Ne-Se-Chete/CableUndefined-Embedded/assets/cable-undefined-poster.pdf

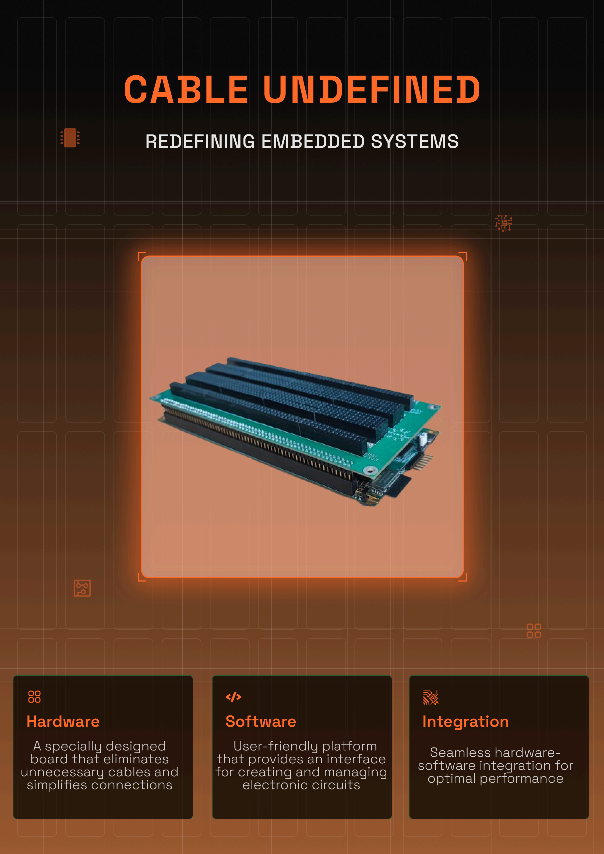
[picture p6: page 1]
