Ne-Se-Chete/CableUndefined-Embedded/assets/gemji-2025.02.01.jpg

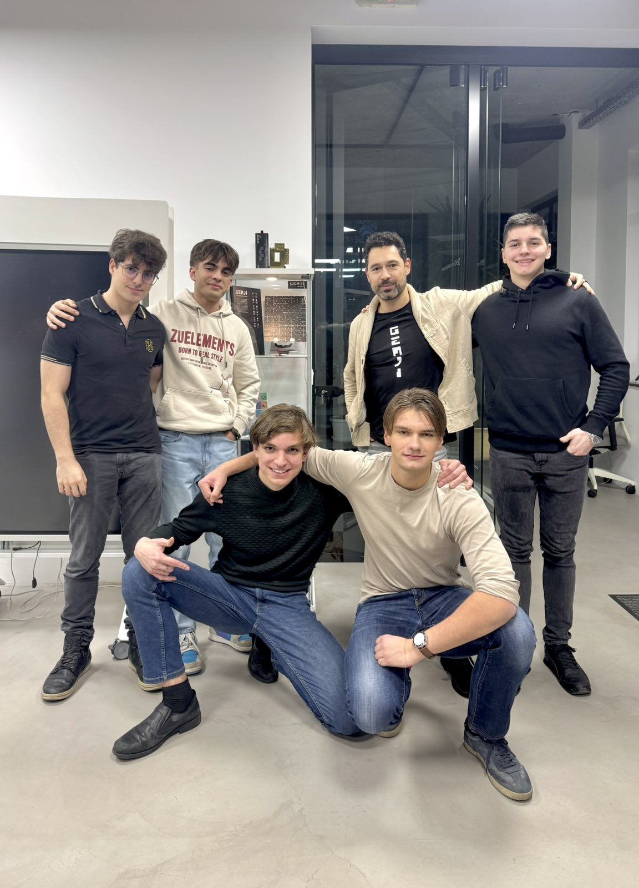
assets/gemji-2025.02.01.jpg
