Ne-Se-Chete/CableUndefined-Embedded/assets/IMG_20231005_111330.jpg

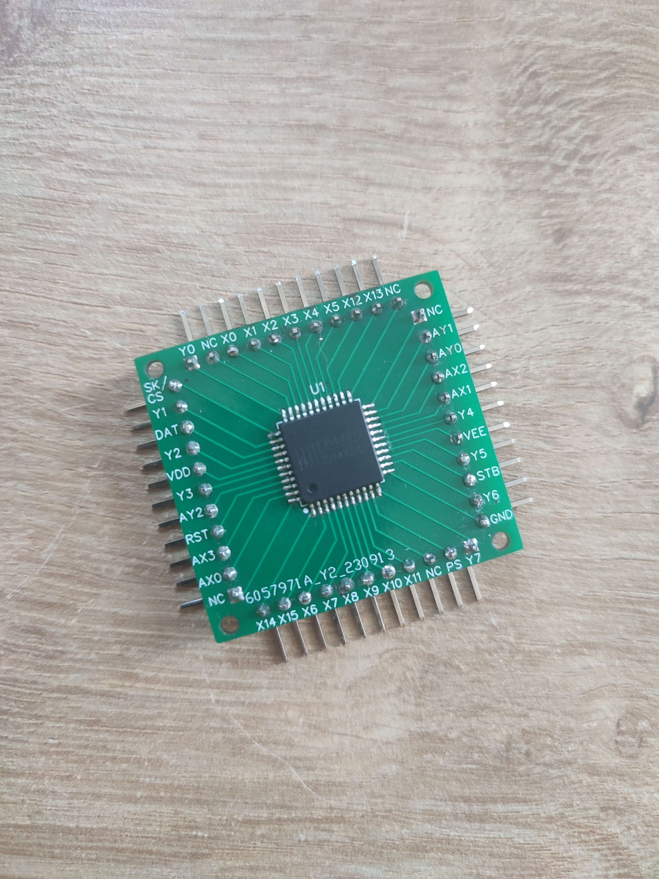
assets/IMG_20231005_111330.jpg
