Ne-Se-Chete/CableUndefined-Embedded/assets/IMG_20240214_160135.jpg

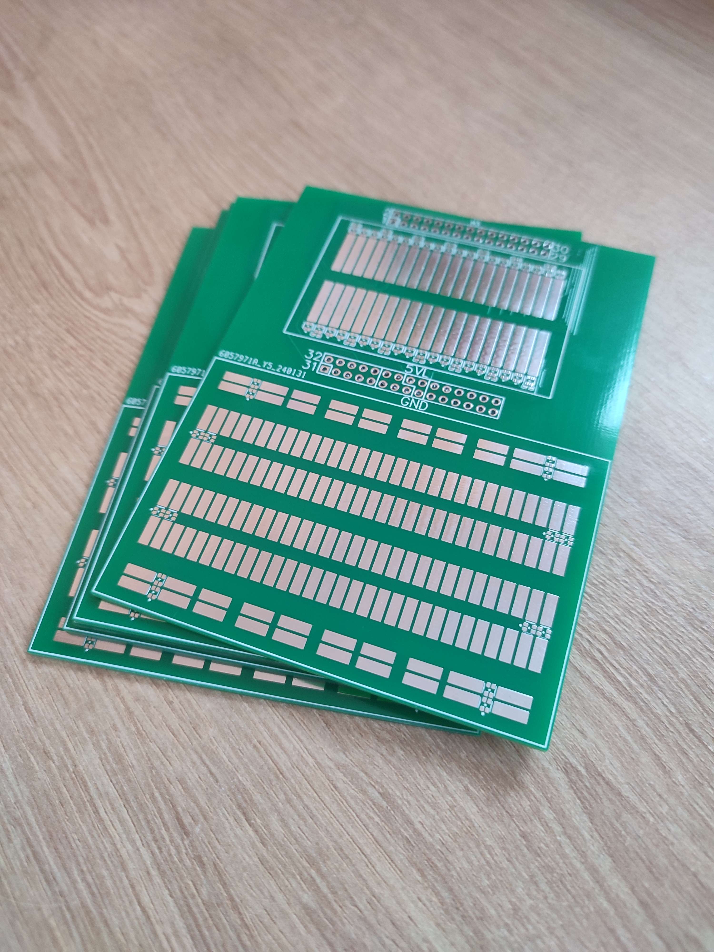
assets/IMG_20240214_160135.jpg
