Ne-Se-Chete/CableUndefined-Embedded/assets/IMG_20240214_160146.jpg

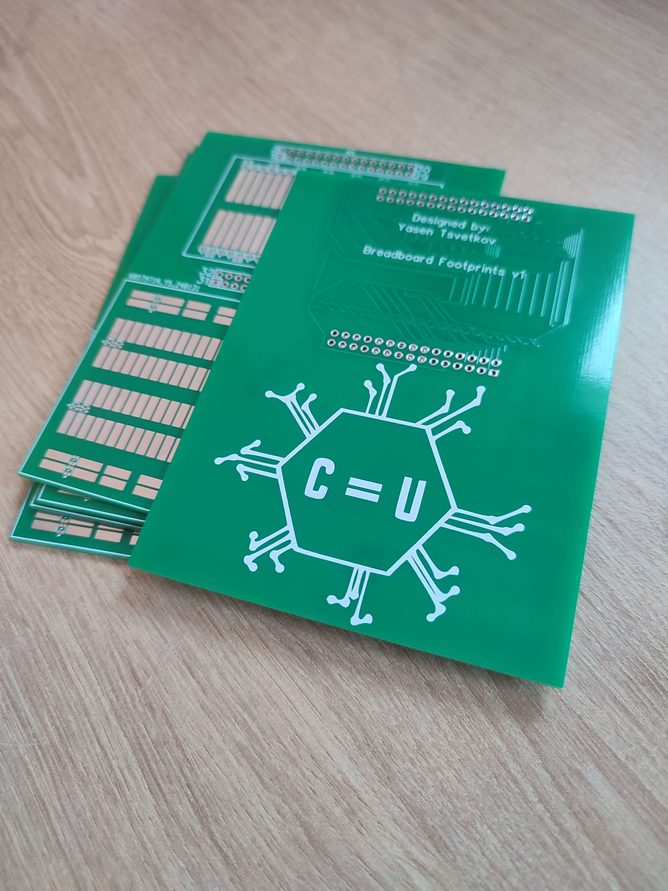
assets/IMG_20240214_160146.jpg
