Ne-Se-Chete/CableUndefined-Embedded/assets/IMG_20240329_173710.jpg

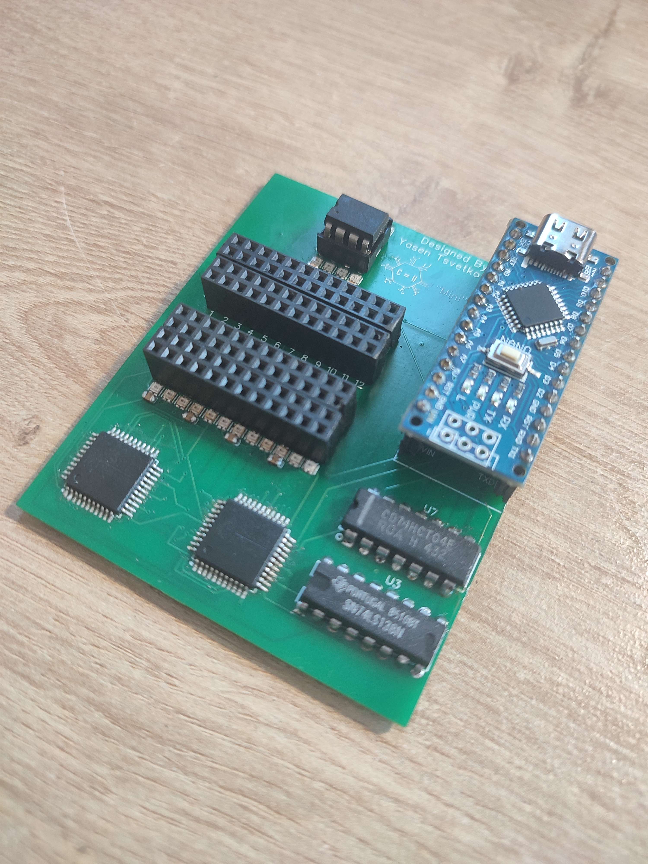
assets/IMG_20240329_173710.jpg
