Ne-Se-Chete/CableUndefined-Embedded/assets/IMG_20240329_173838.jpg

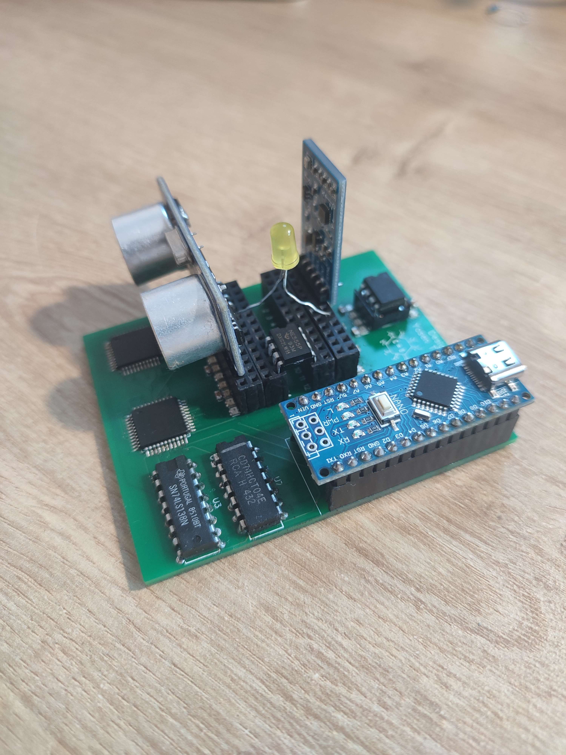
assets/IMG_20240329_173838.jpg
