Ne-Se-Chete/CableUndefined-Embedded/assets/IMG_20240329_174744.jpg

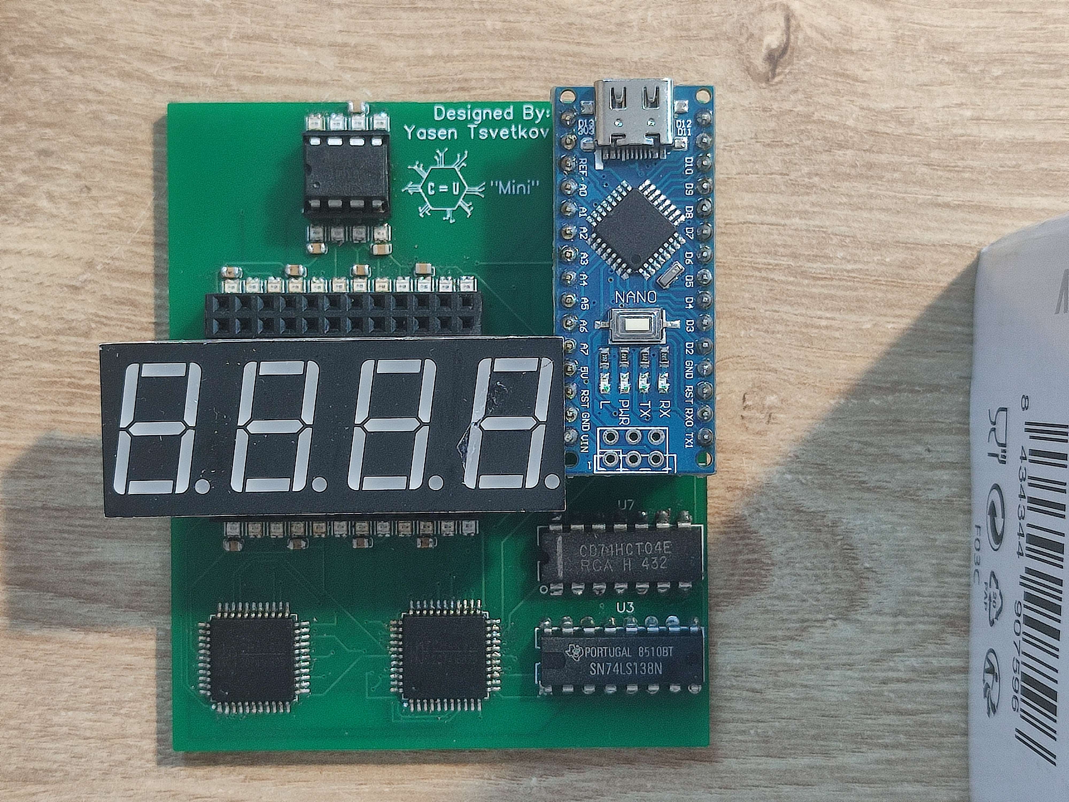
assets/IMG_20240329_174744.jpg
