Ne-Se-Chete/CableUndefined-Embedded/assets/IMG_20240329_174848.jpg

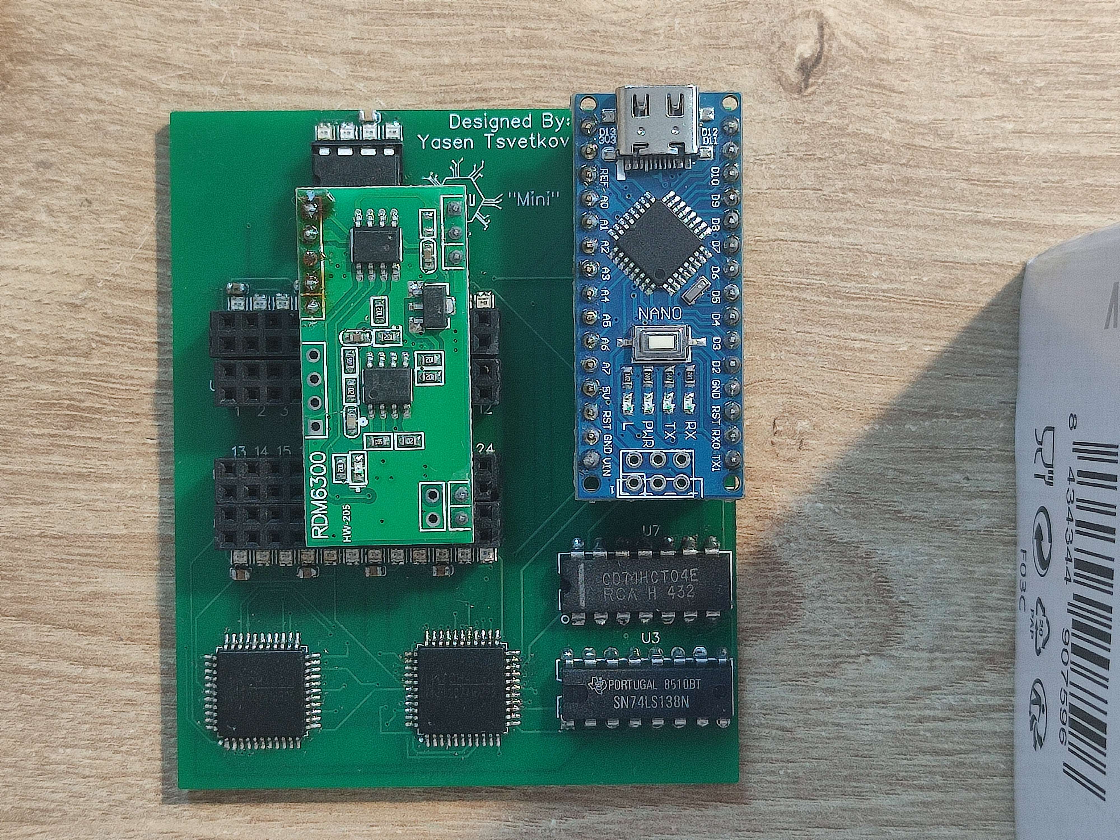
assets/IMG_20240329_174848.jpg
