Ne-Se-Chete/CableUndefined-Embedded/assets/IMG_20240329_175025.jpg

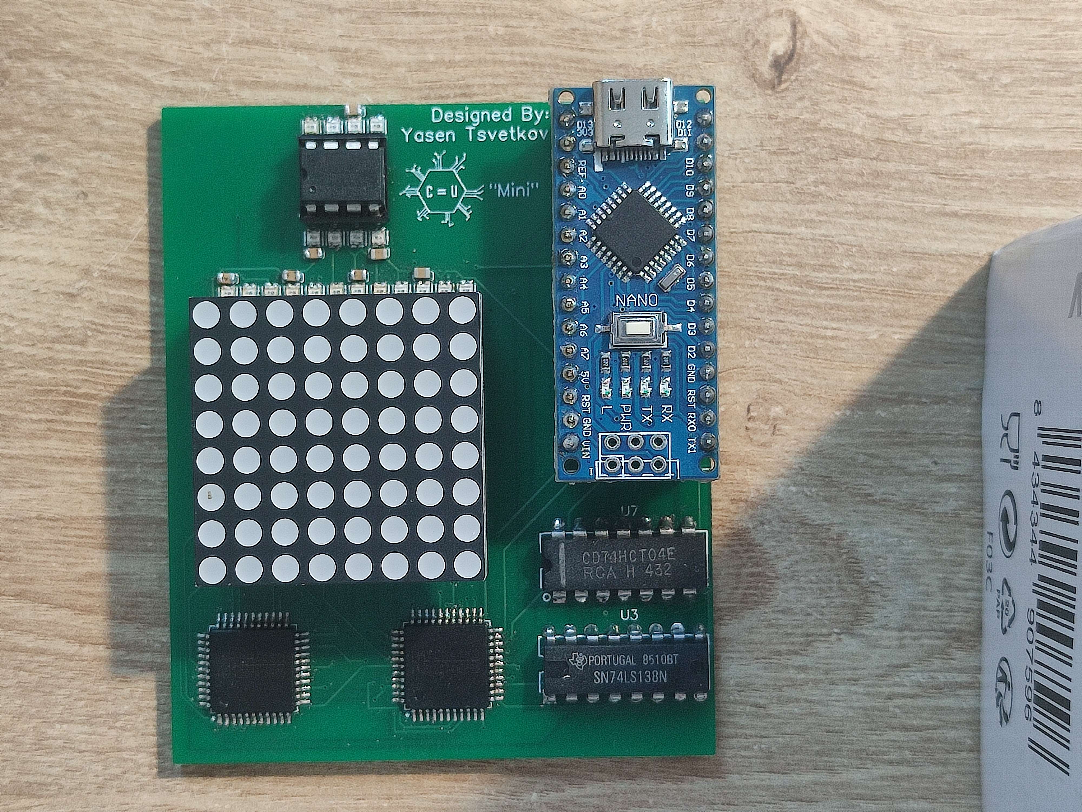
assets/IMG_20240329_175025.jpg
