Ne-Se-Chete/CableUndefined-Embedded/assets/IMG_20240329_175111.jpg

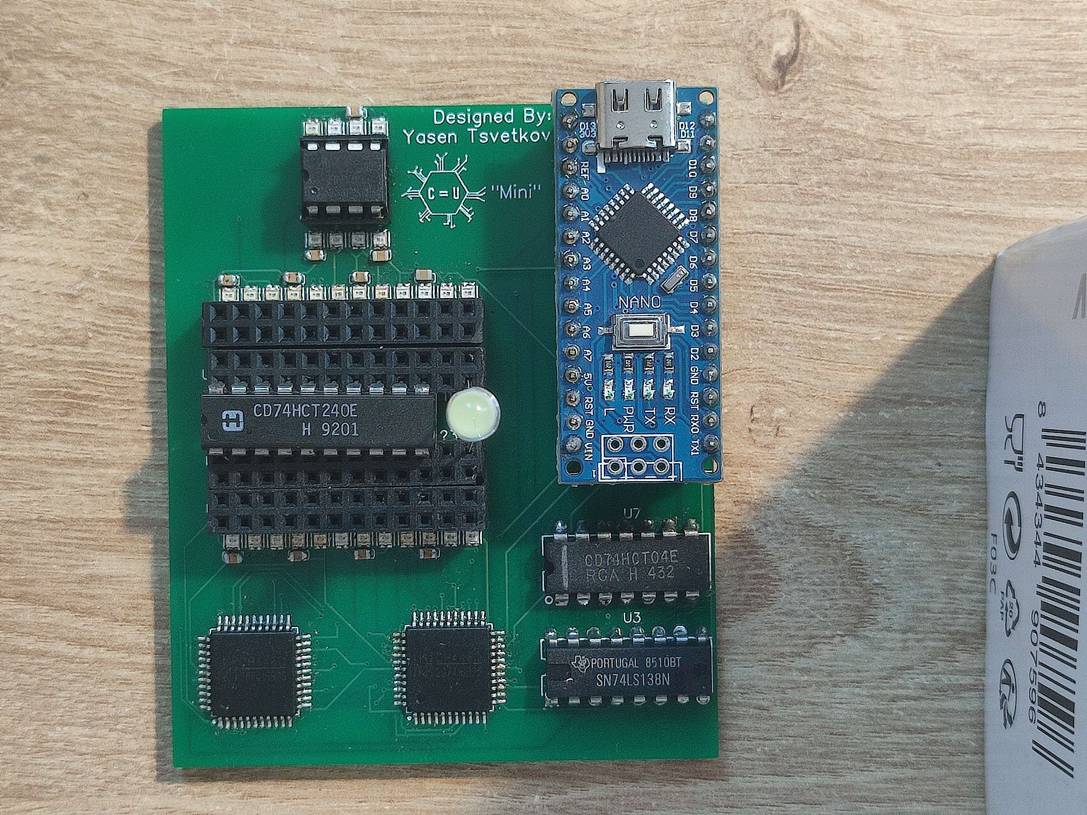
assets/IMG_20240329_175111.jpg
