Ne-Se-Chete/CableUndefined-Embedded/assets/IMG_20240329_175406.jpg

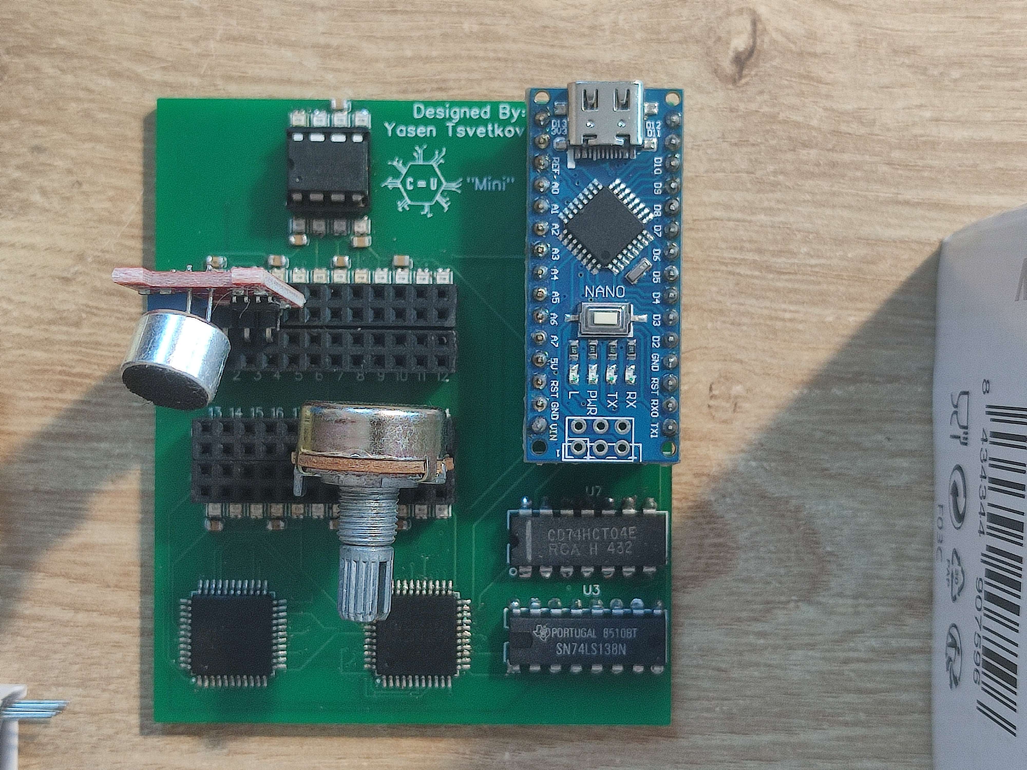
assets/IMG_20240329_175406.jpg
