Ne-Se-Chete/CableUndefined-Embedded/assets/nsc-2.jpg

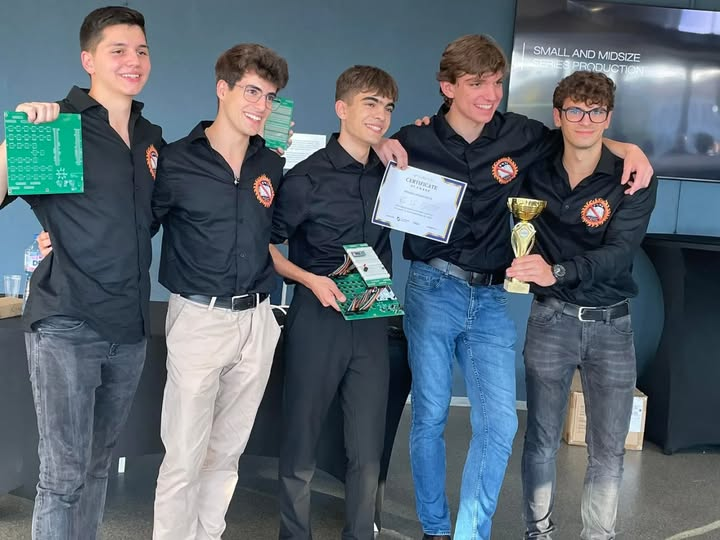
assets/nsc-2.jpg
