Ne-Se-Chete/CableUndefined-Embedded/assets/viber_image_2025-03-26_13-28-42-523.jpg

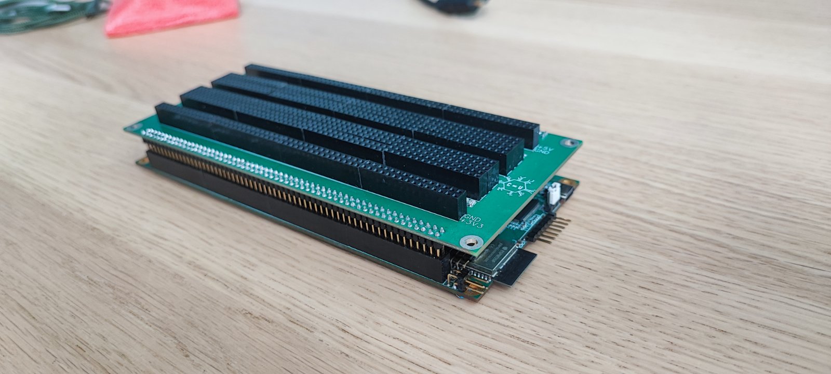
assets/viber_image_2025-03-26_13-28-42-523.jpg
