Ne-Se-Chete/CableUndefined-Embedded/assets/viber_image_2025-03-26_13-28-44-215.jpg

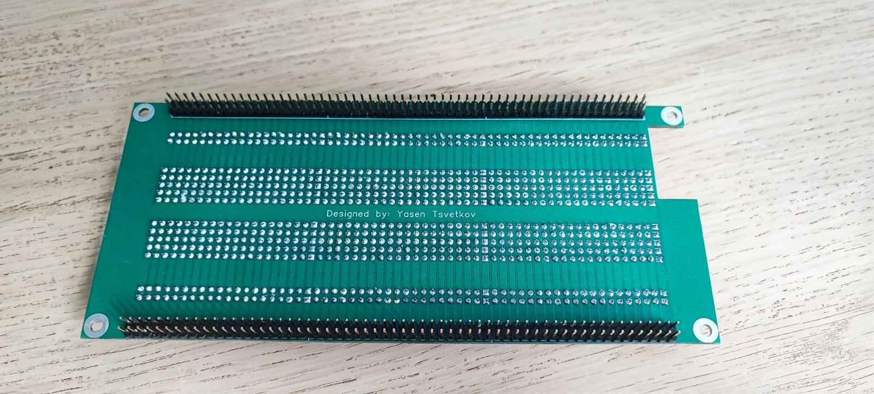
assets/viber_image_2025-03-26_13-28-44-215.jpg
