Ne-Se-Chete/CableUndefined-Embedded/assets/viber_image_2025-03-26_13-28-46-500.jpg

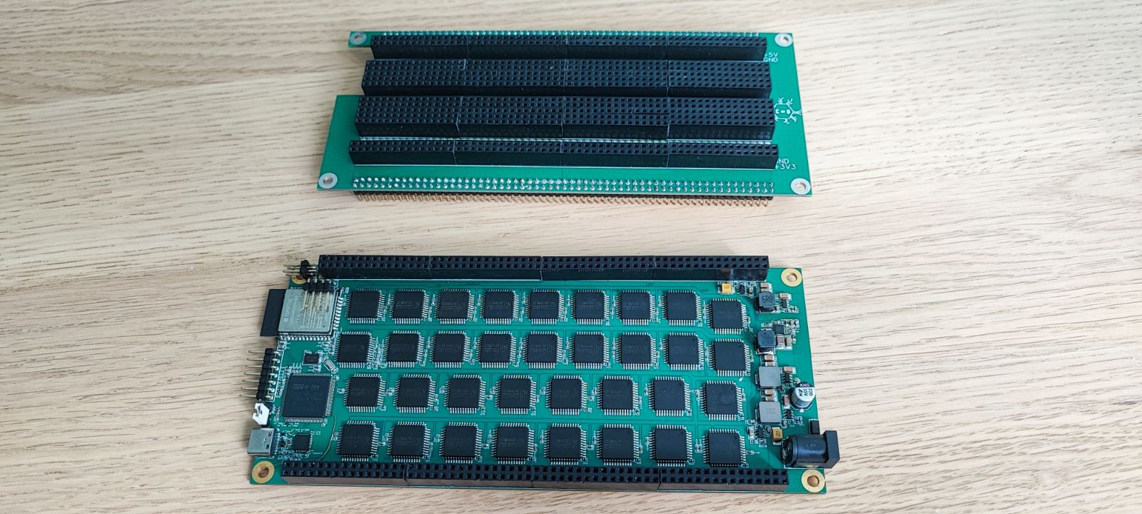
assets/viber_image_2025-03-26_13-28-46-500.jpg
