Ne-Se-Chete/CableUndefined-Embedded/assets/viber_image_2025-03-26_13-30-22-813.jpg

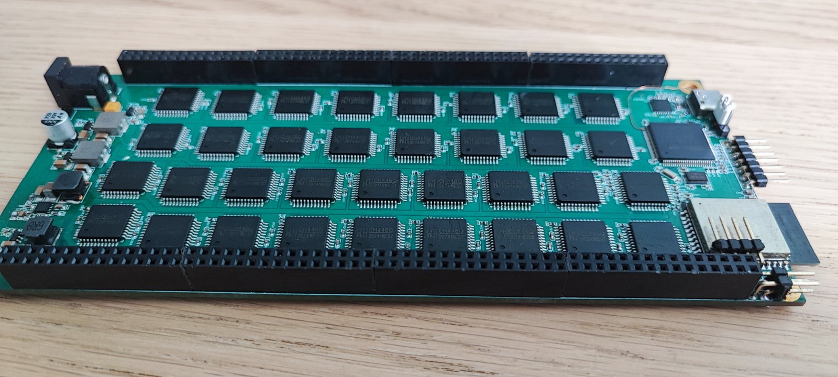
assets/viber_image_2025-03-26_13-30-22-813.jpg
