Ne-Se-Chete/CableUndefined-Embedded/assets/viber_image_2025-03-26_13-31-24-213.jpg

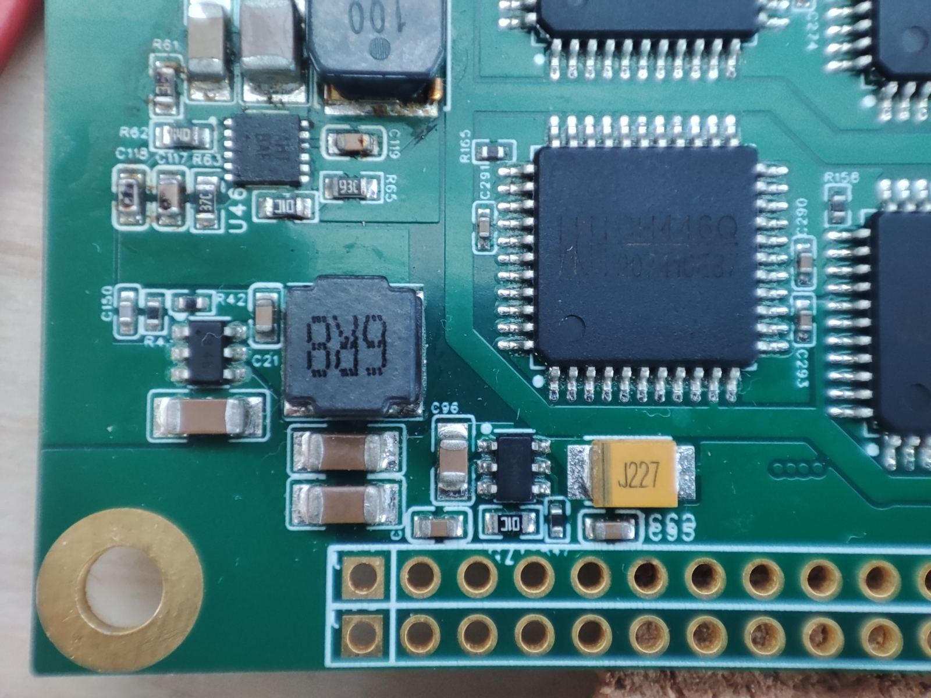
assets/viber_image_2025-03-26_13-31-24-213.jpg
