Ne-Se-Chete/CableUndefined-Embedded/assets/viber_image_2025-03-26_13-31-25-889.jpg

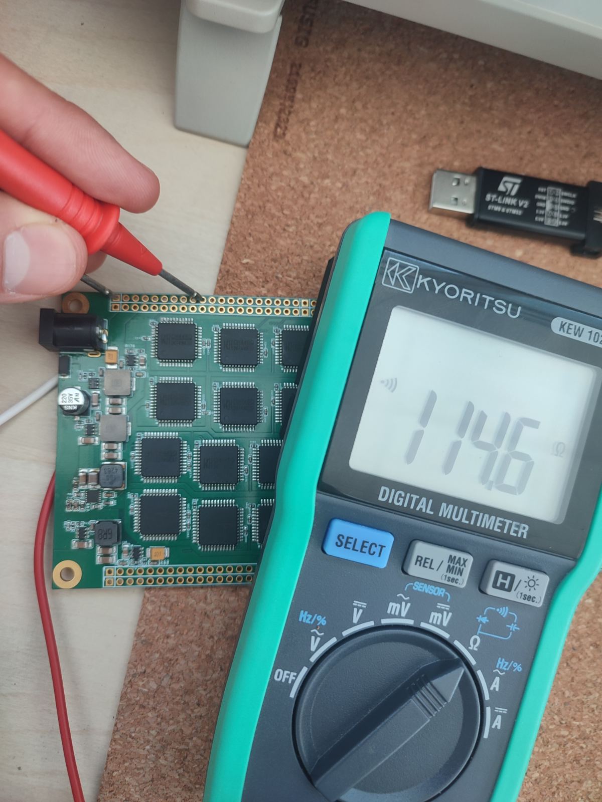
assets/viber_image_2025-03-26_13-31-25-889.jpg
