Ne-Se-Chete/CableUndefined-Embedded/(threads)

Thread 11 (2025-03-10):

Research web sockets in Spring Boot

TIVMOF, 2025-03-10:
Research how web sockets work with Spring Boot and plan next issues accordingly.

Closed 2025-04-15.
