Ne-Se-Chete/CableUndefined-Embedded/Cable Undefined V3/Schematics/Cable Undefined Bottom.pdf

# NC 15 NC 16 NC 17 NC 18 NC 19 NC 20 NC 21

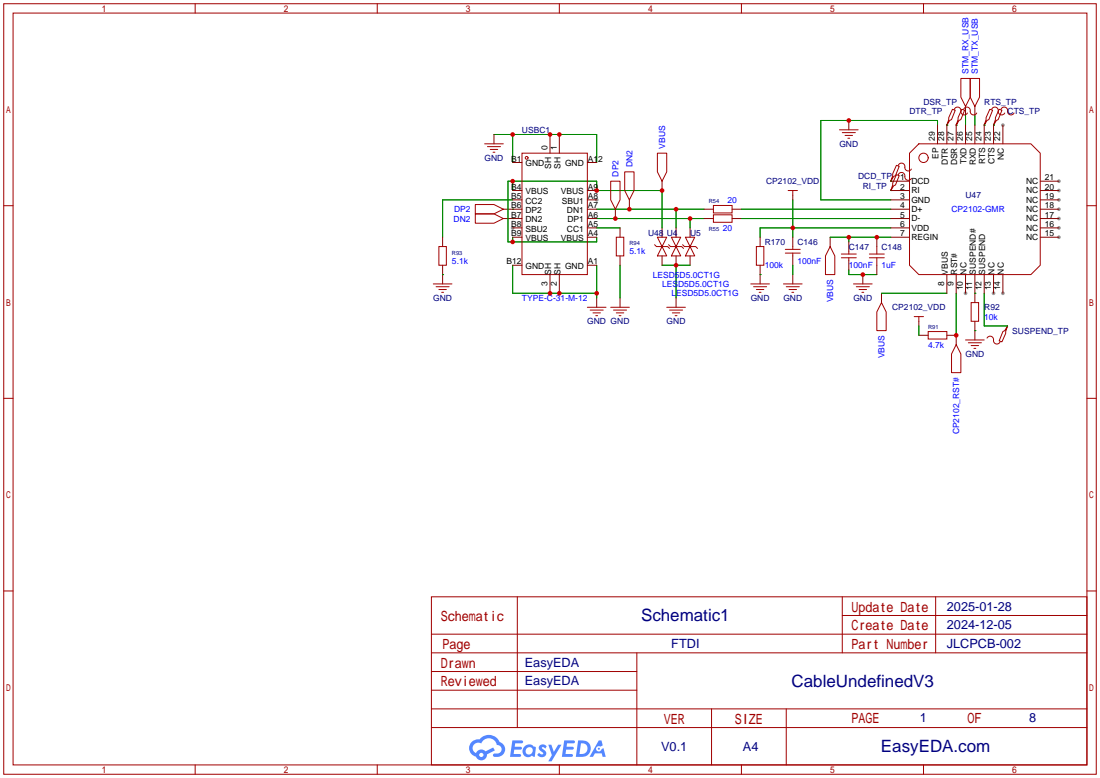
[picture p39: page 1]

NC 22 CTS 23 RTS 24 RXD 25 TXD 26 DSR 27 DTR 28 EP 29

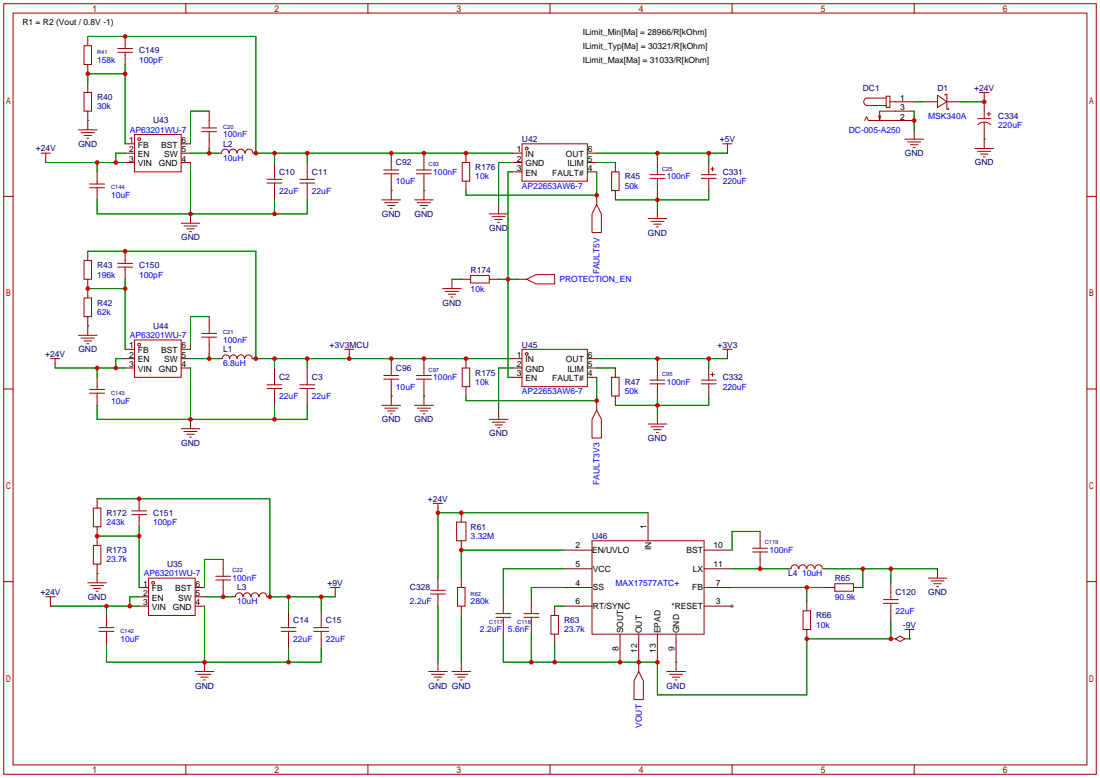
[picture p40: page 2]

# Breadboard TOP MUXes

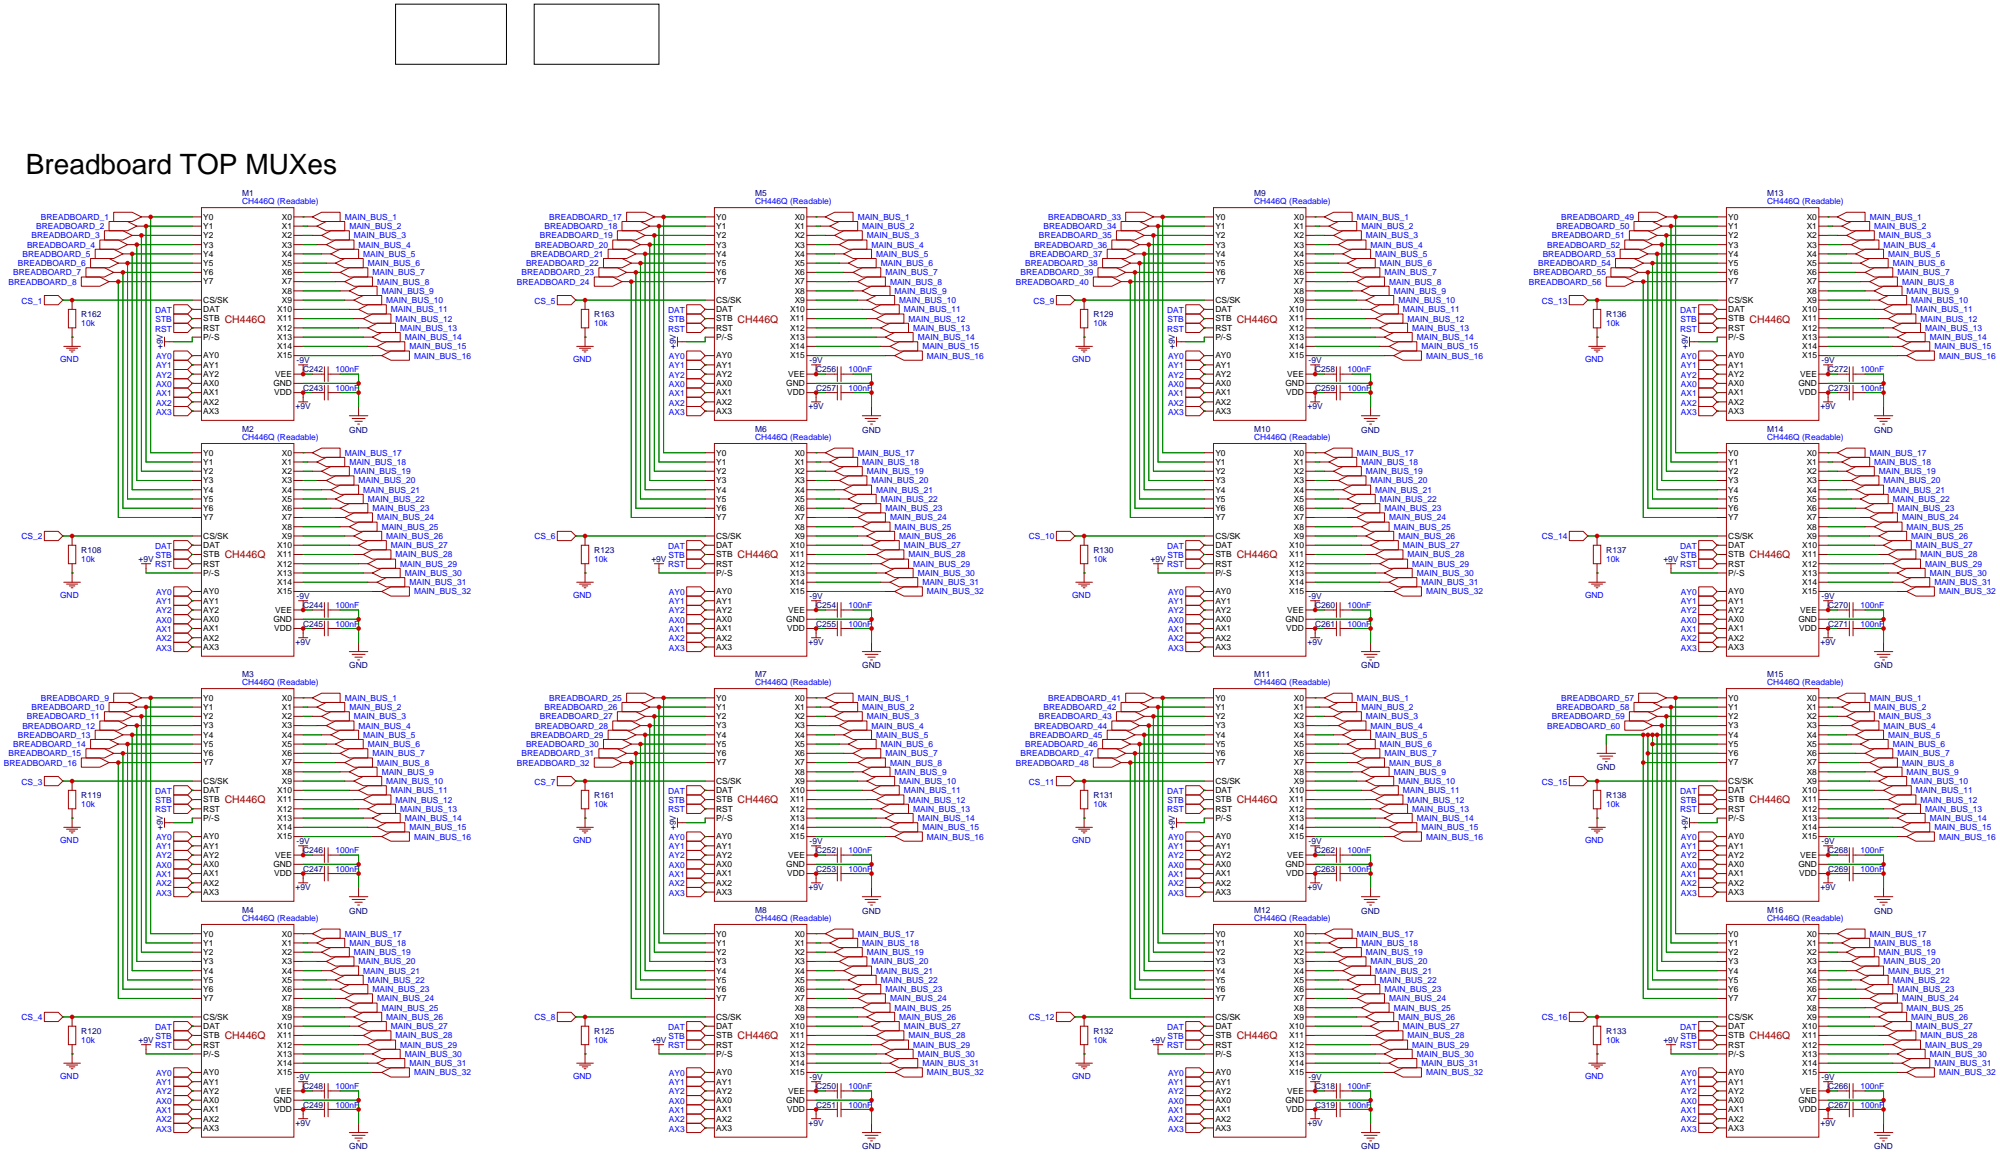
[picture p41: page 3]

### CH446Q

### CH446Q

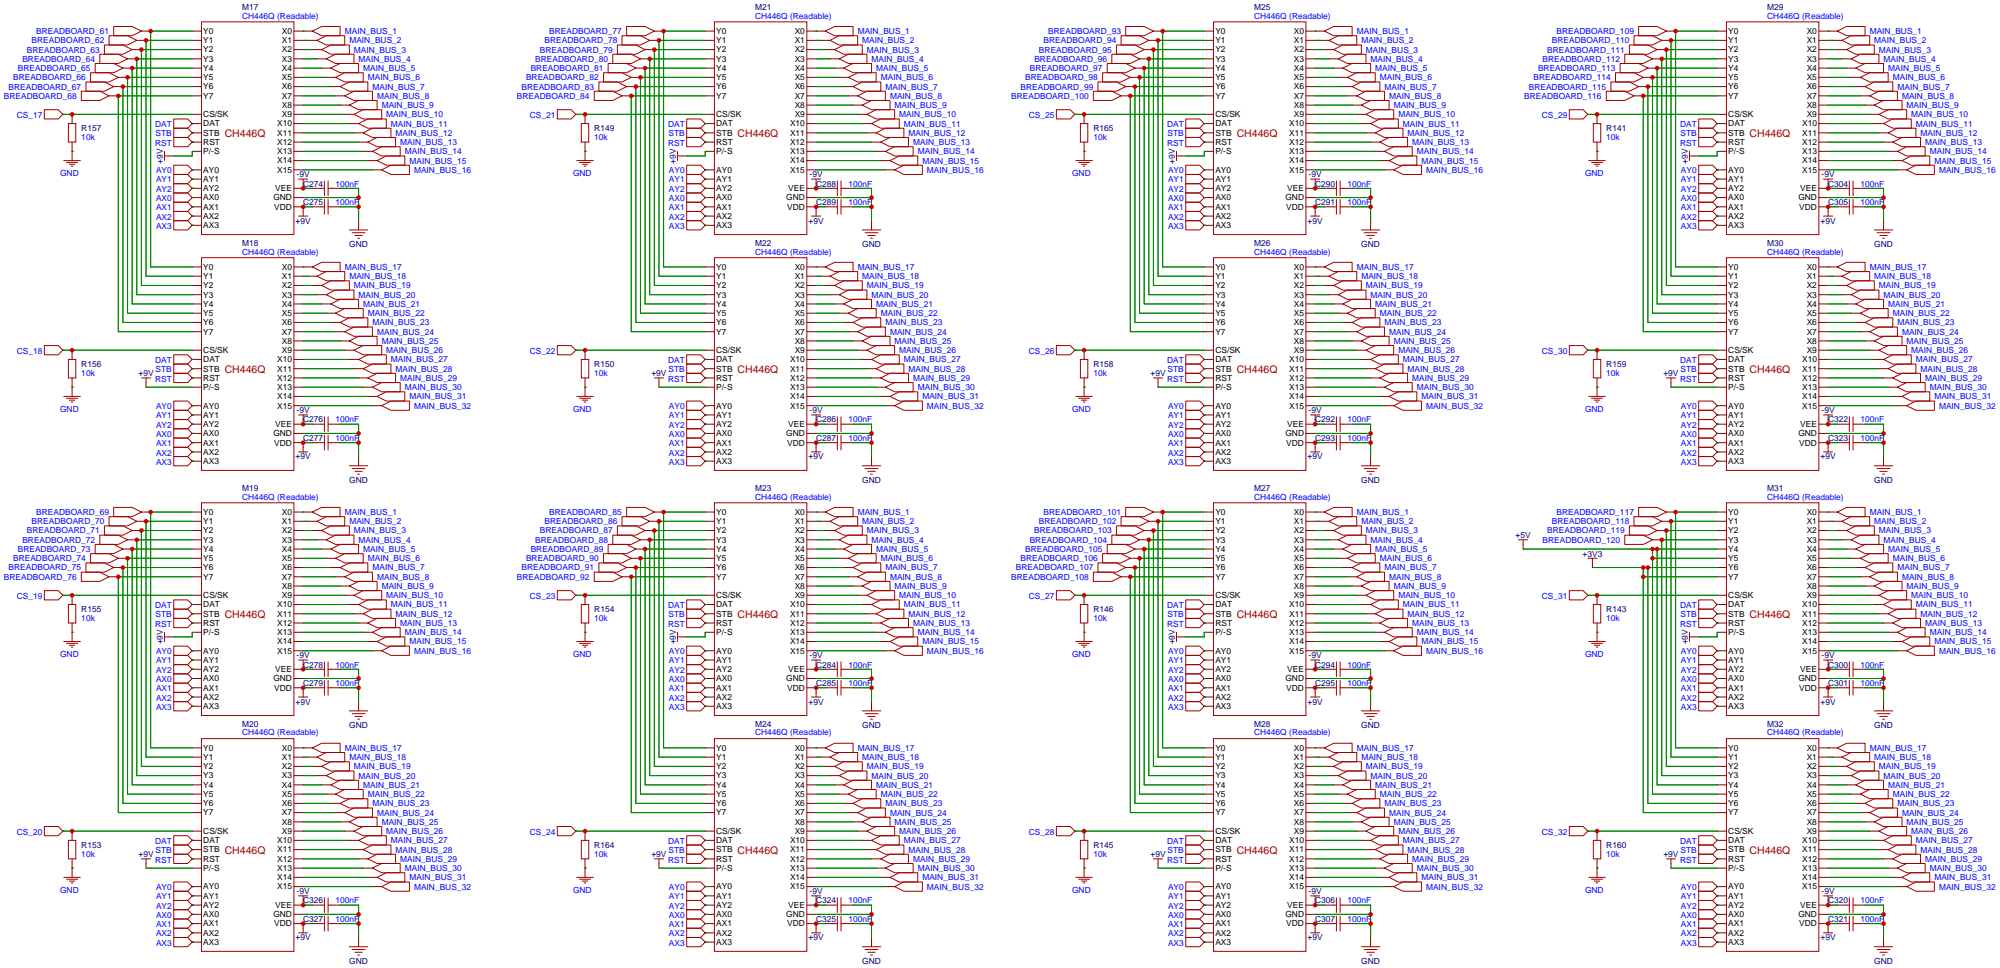
[picture p42: page 4]

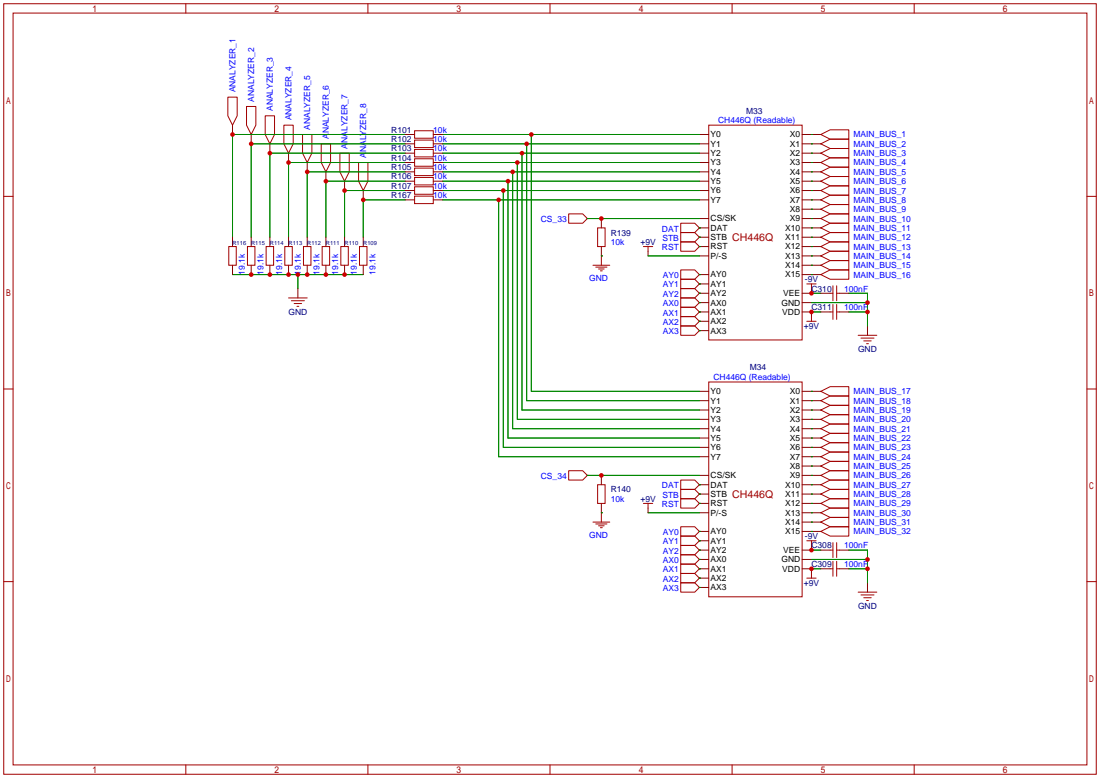
[picture p43: page 5]

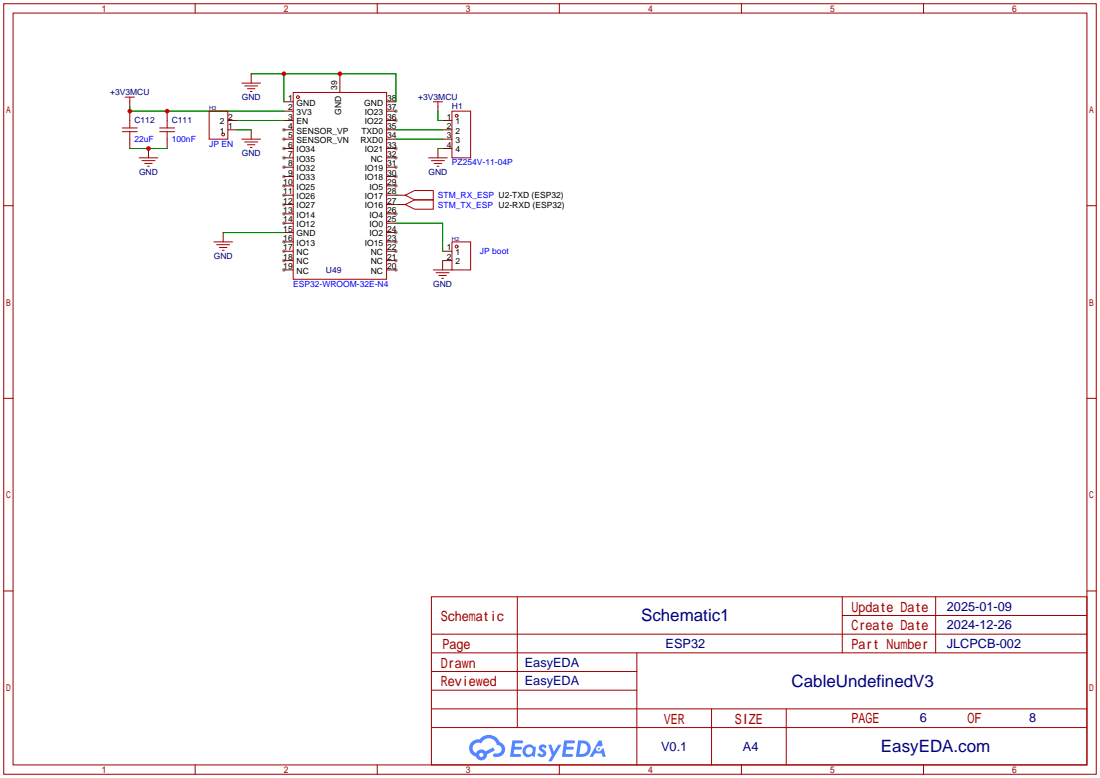
[picture p44: page 6]

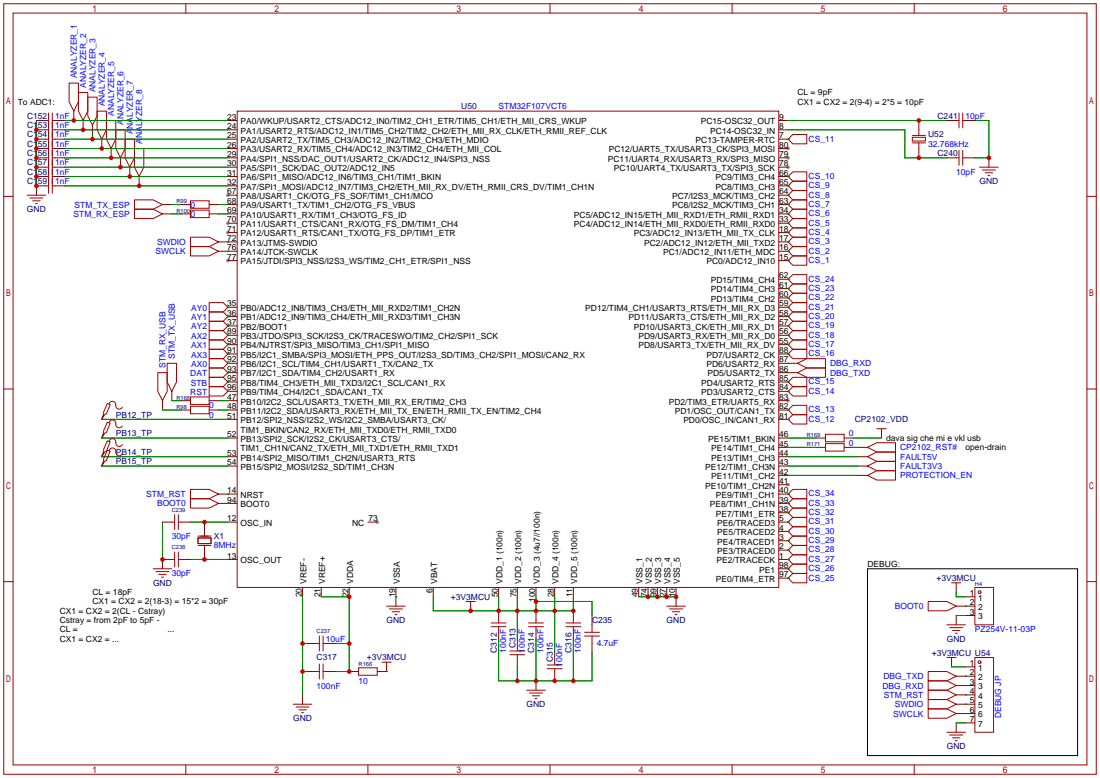
[picture p45: page 7]

CX1 = CX2 = 2(CL - Cstray)
Cstray = from 2pF to 5pF - Паразитен капацитет на пистата
CL = на кристала...

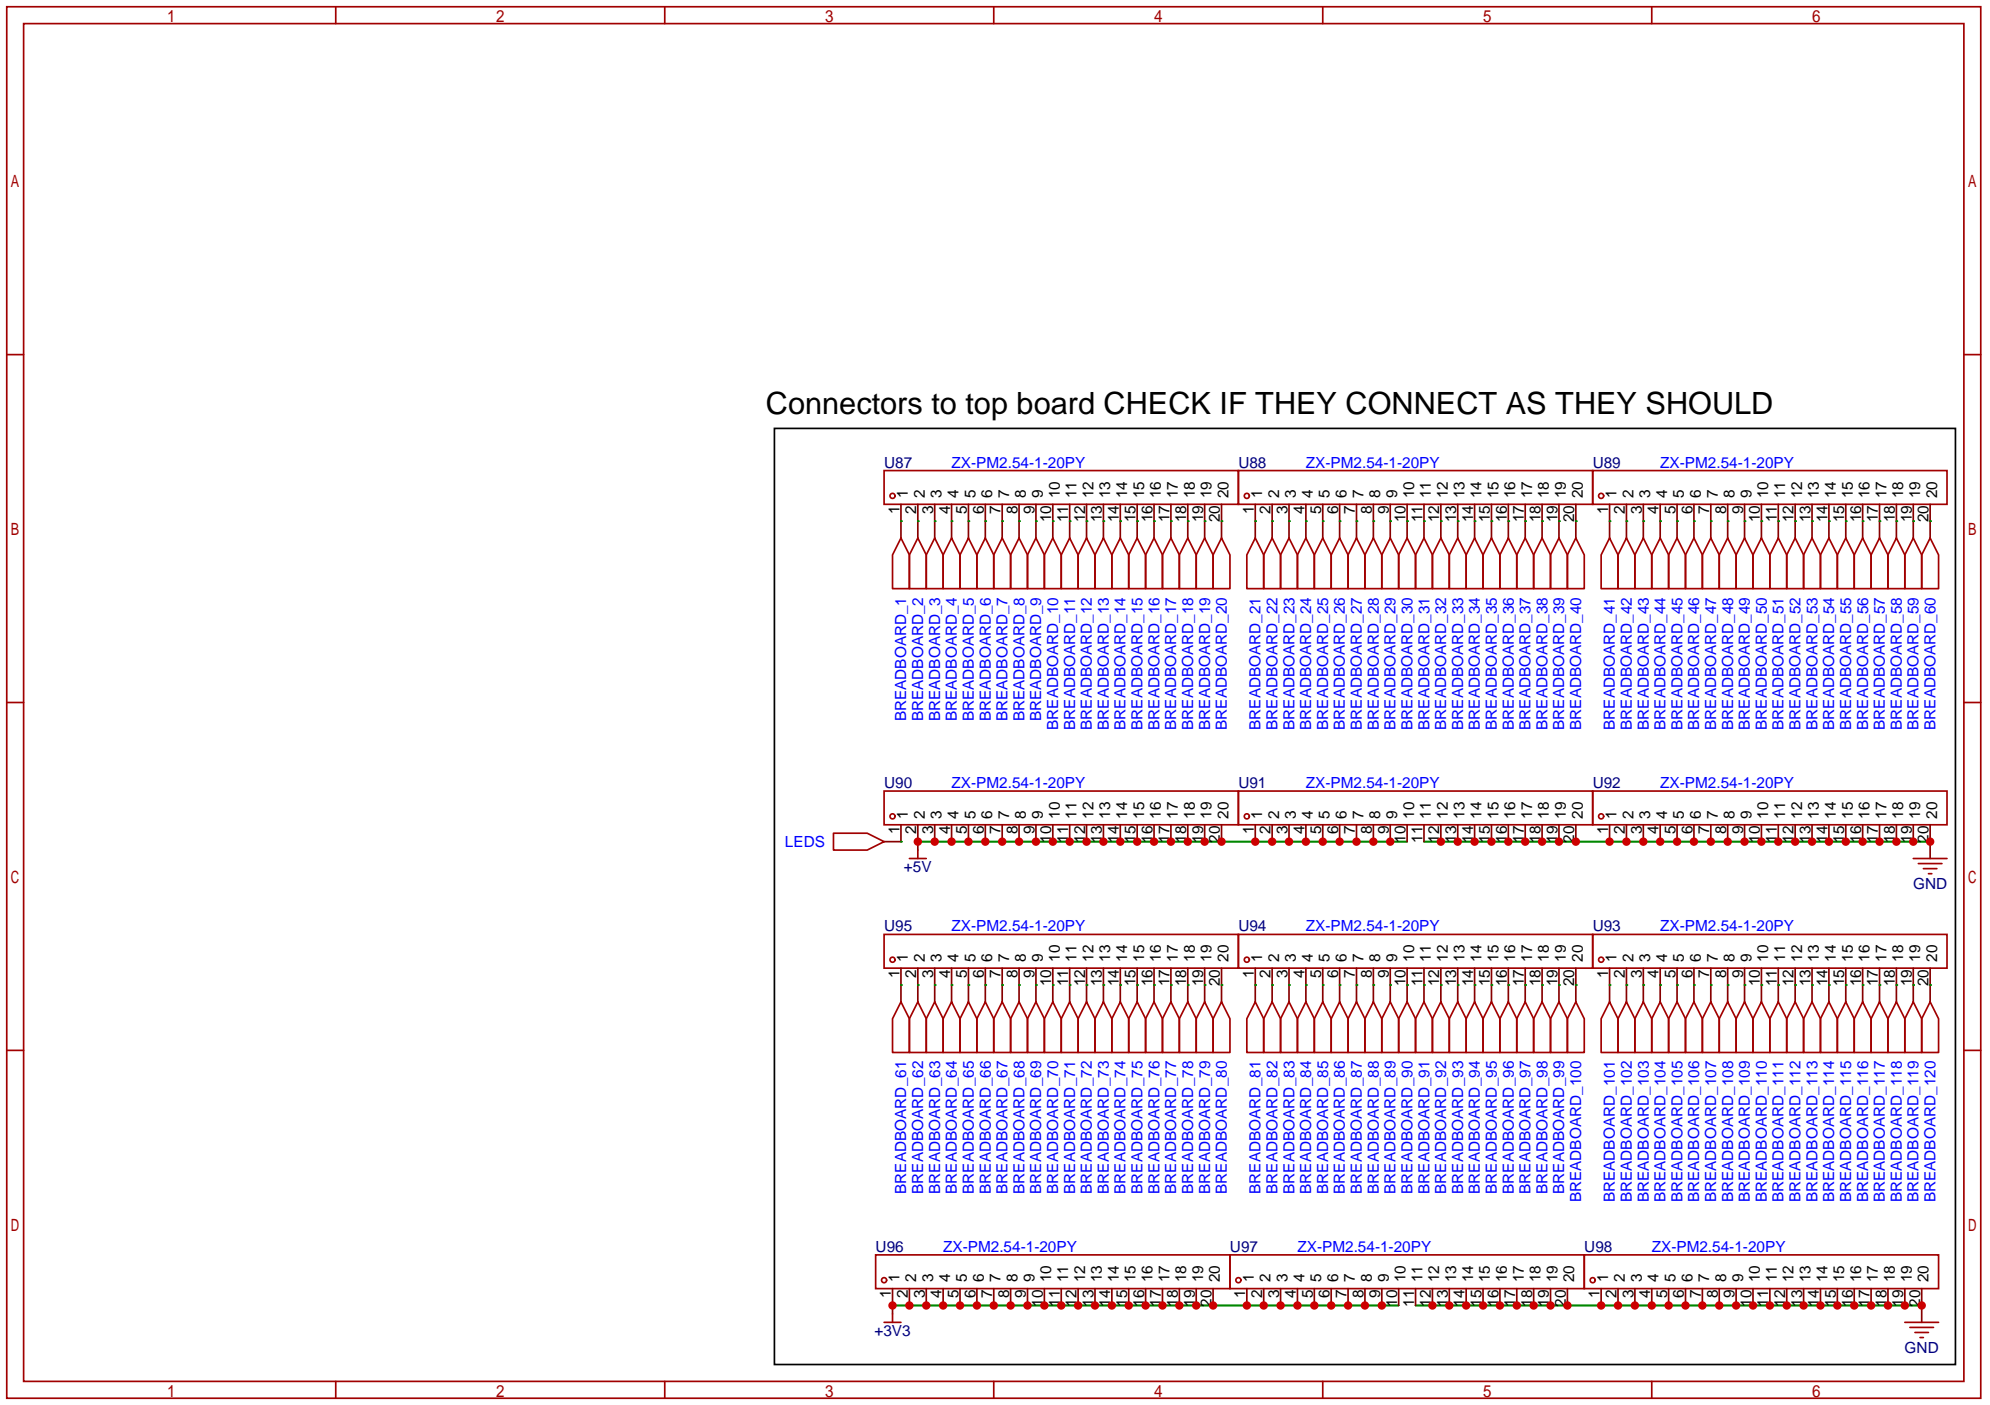
[picture p46: page 8]

Connectors to top board CHECK IF THEY CONNECT AS THEY SHOULD
