Ne-Se-Chete/CableUndefined-Embedded/Cable Undefined V3/Schematics/Cable Undefined Top.pdf

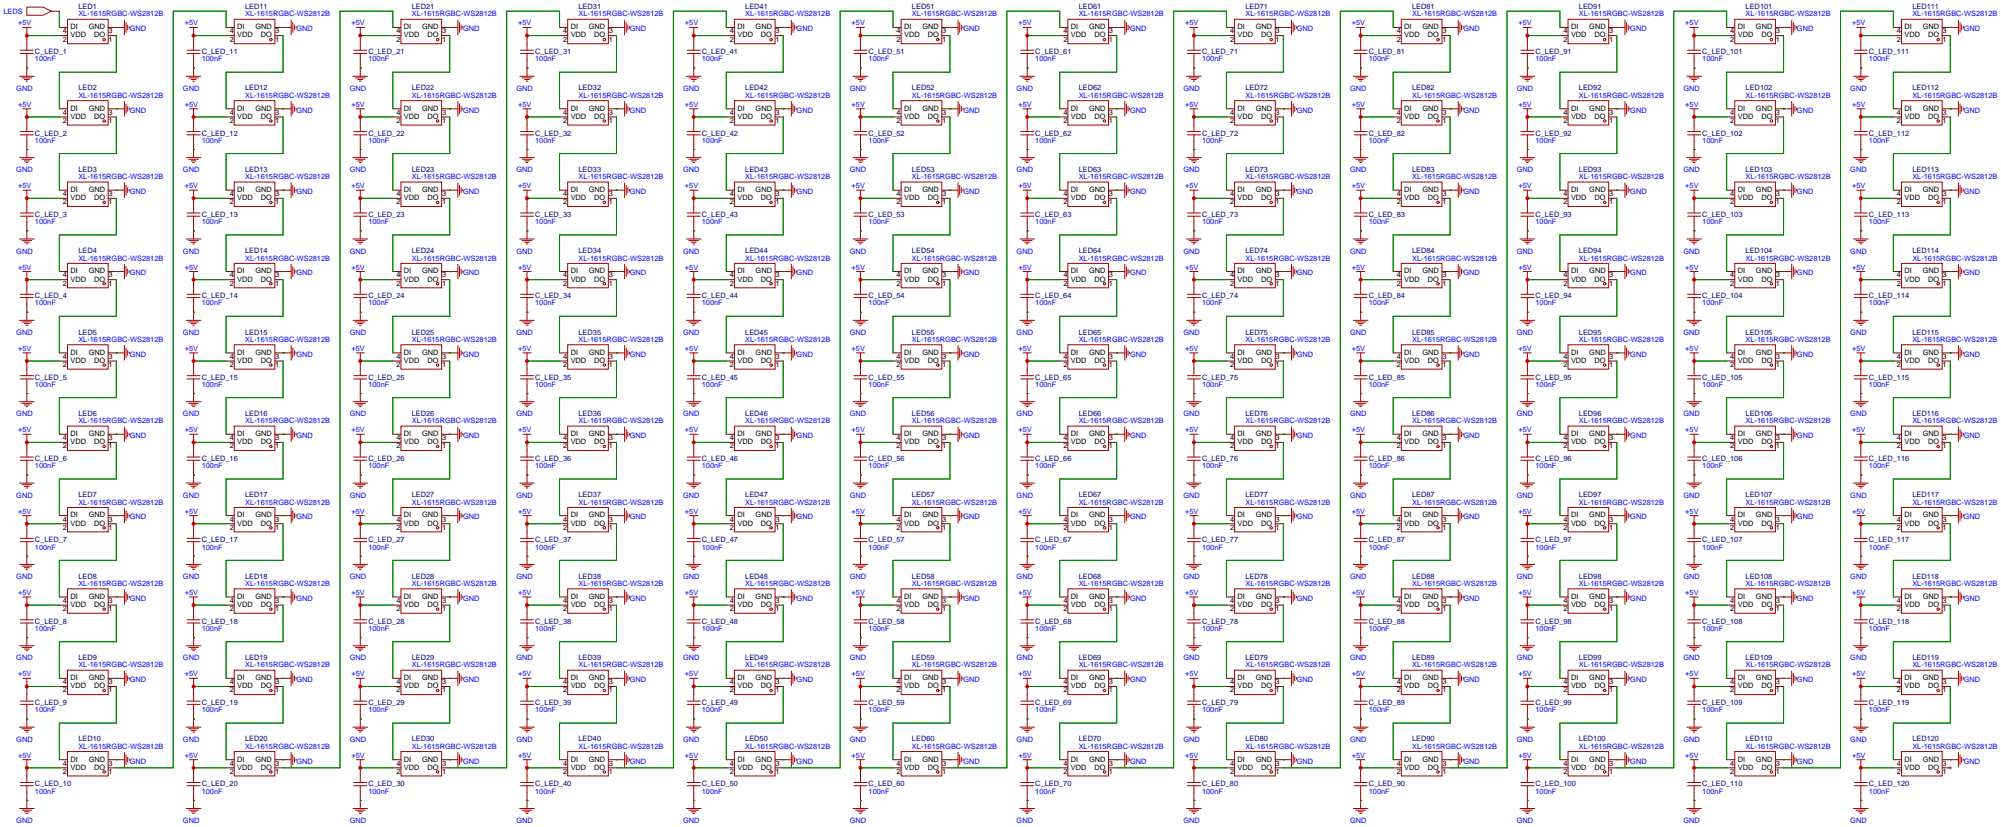
[picture p47: page 1]

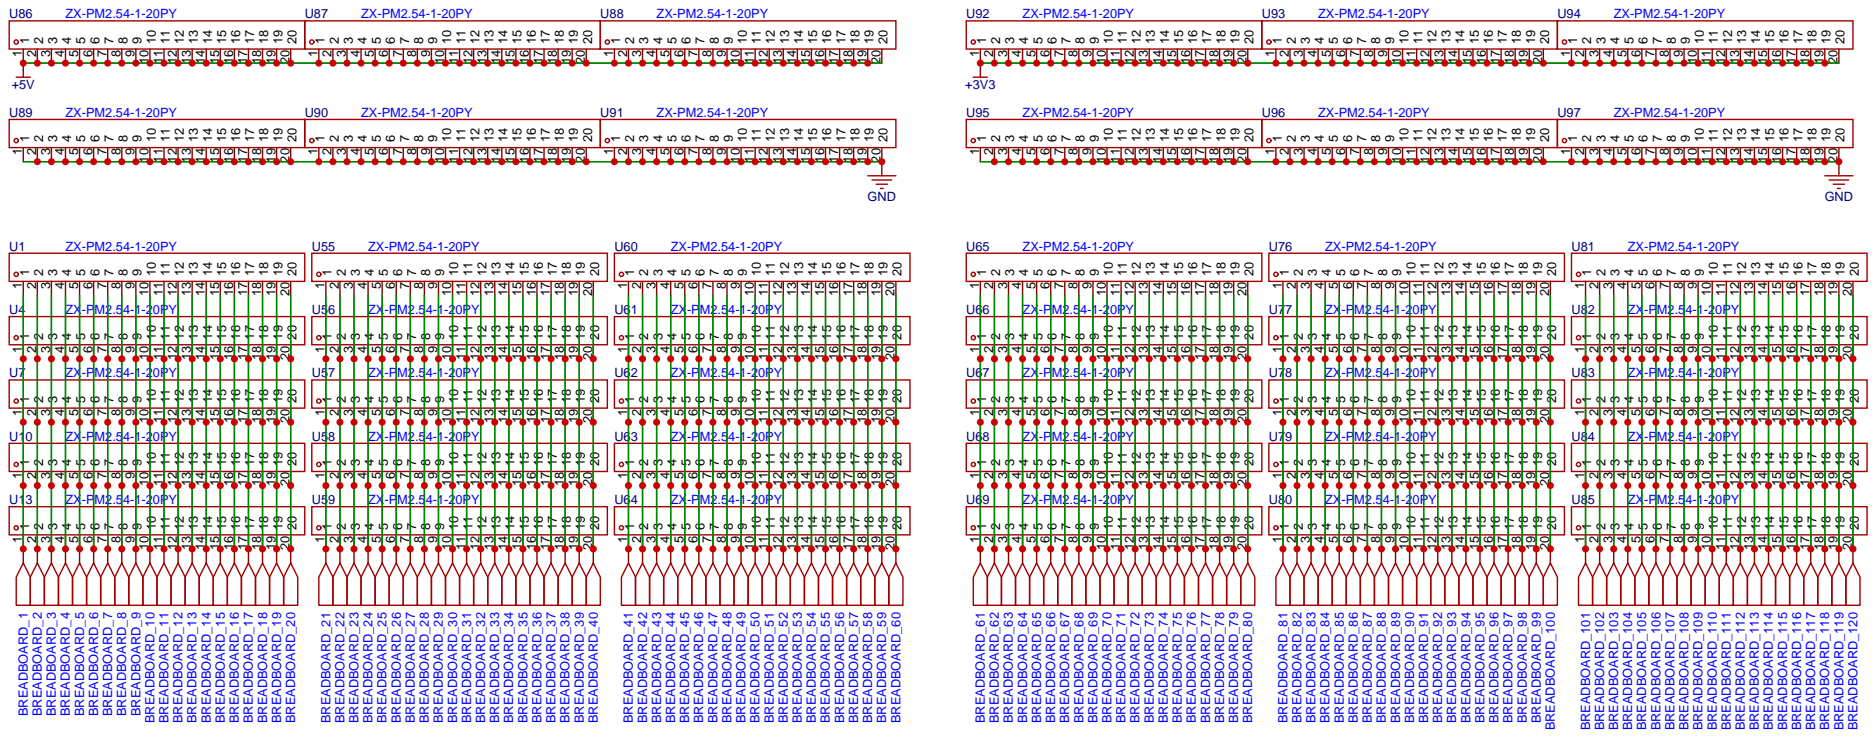
[picture p48: page 2]

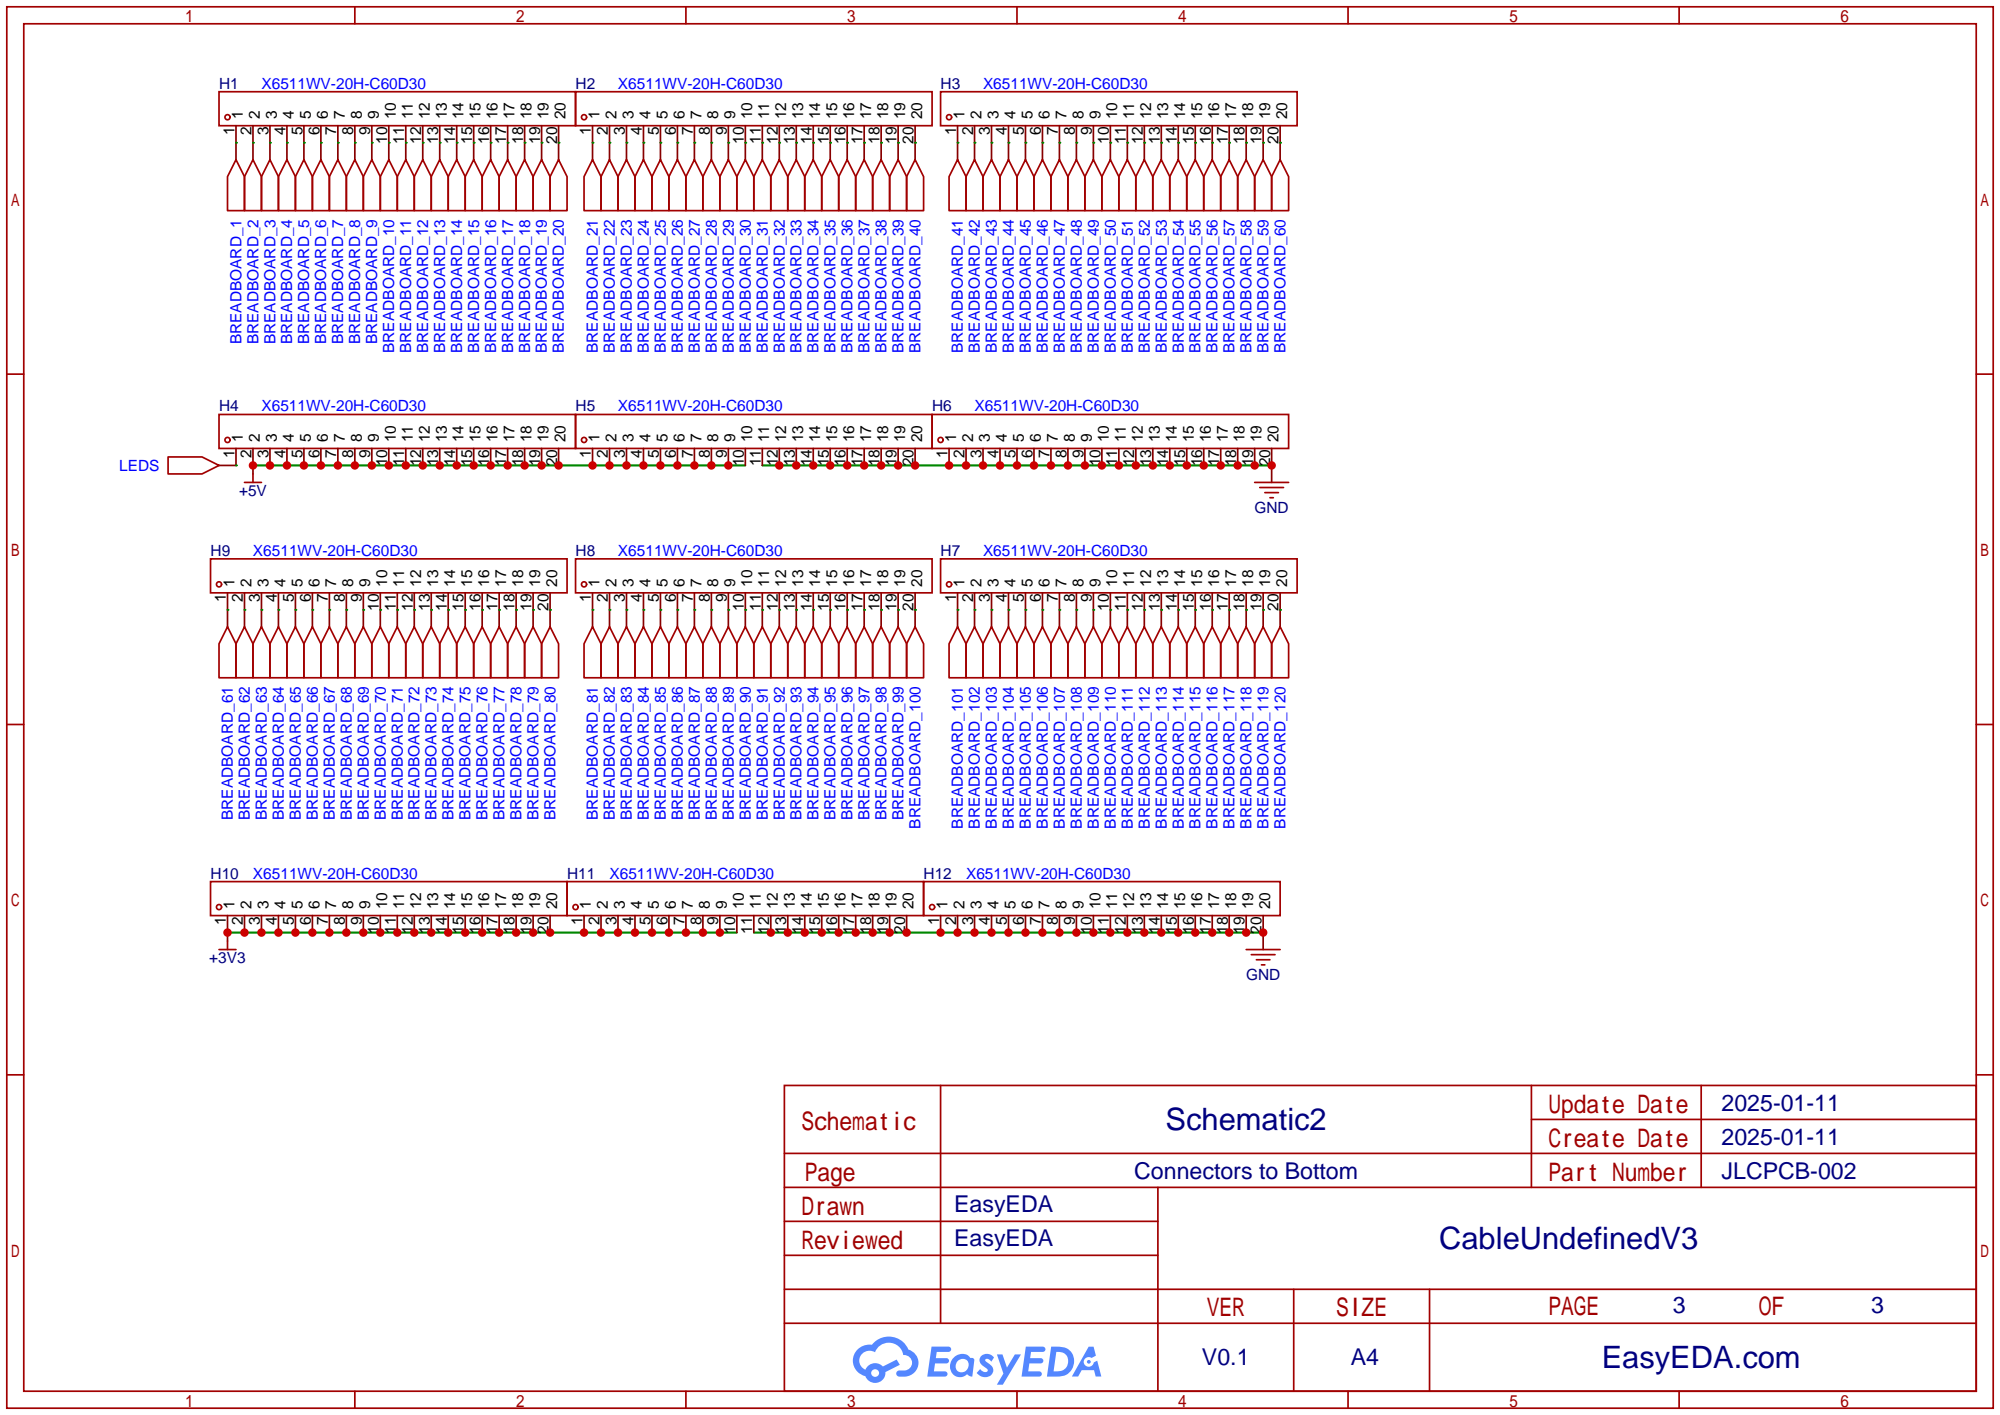
[picture p49: page 3]
