Ne-Se-Chete/CableUndefined-Embedded/Cable Undefined V1/PCB's/Main PCB/Schematic_CableUndefined1stPrototype_2024-05-10.pdf

## MCU Breadboard LEDs

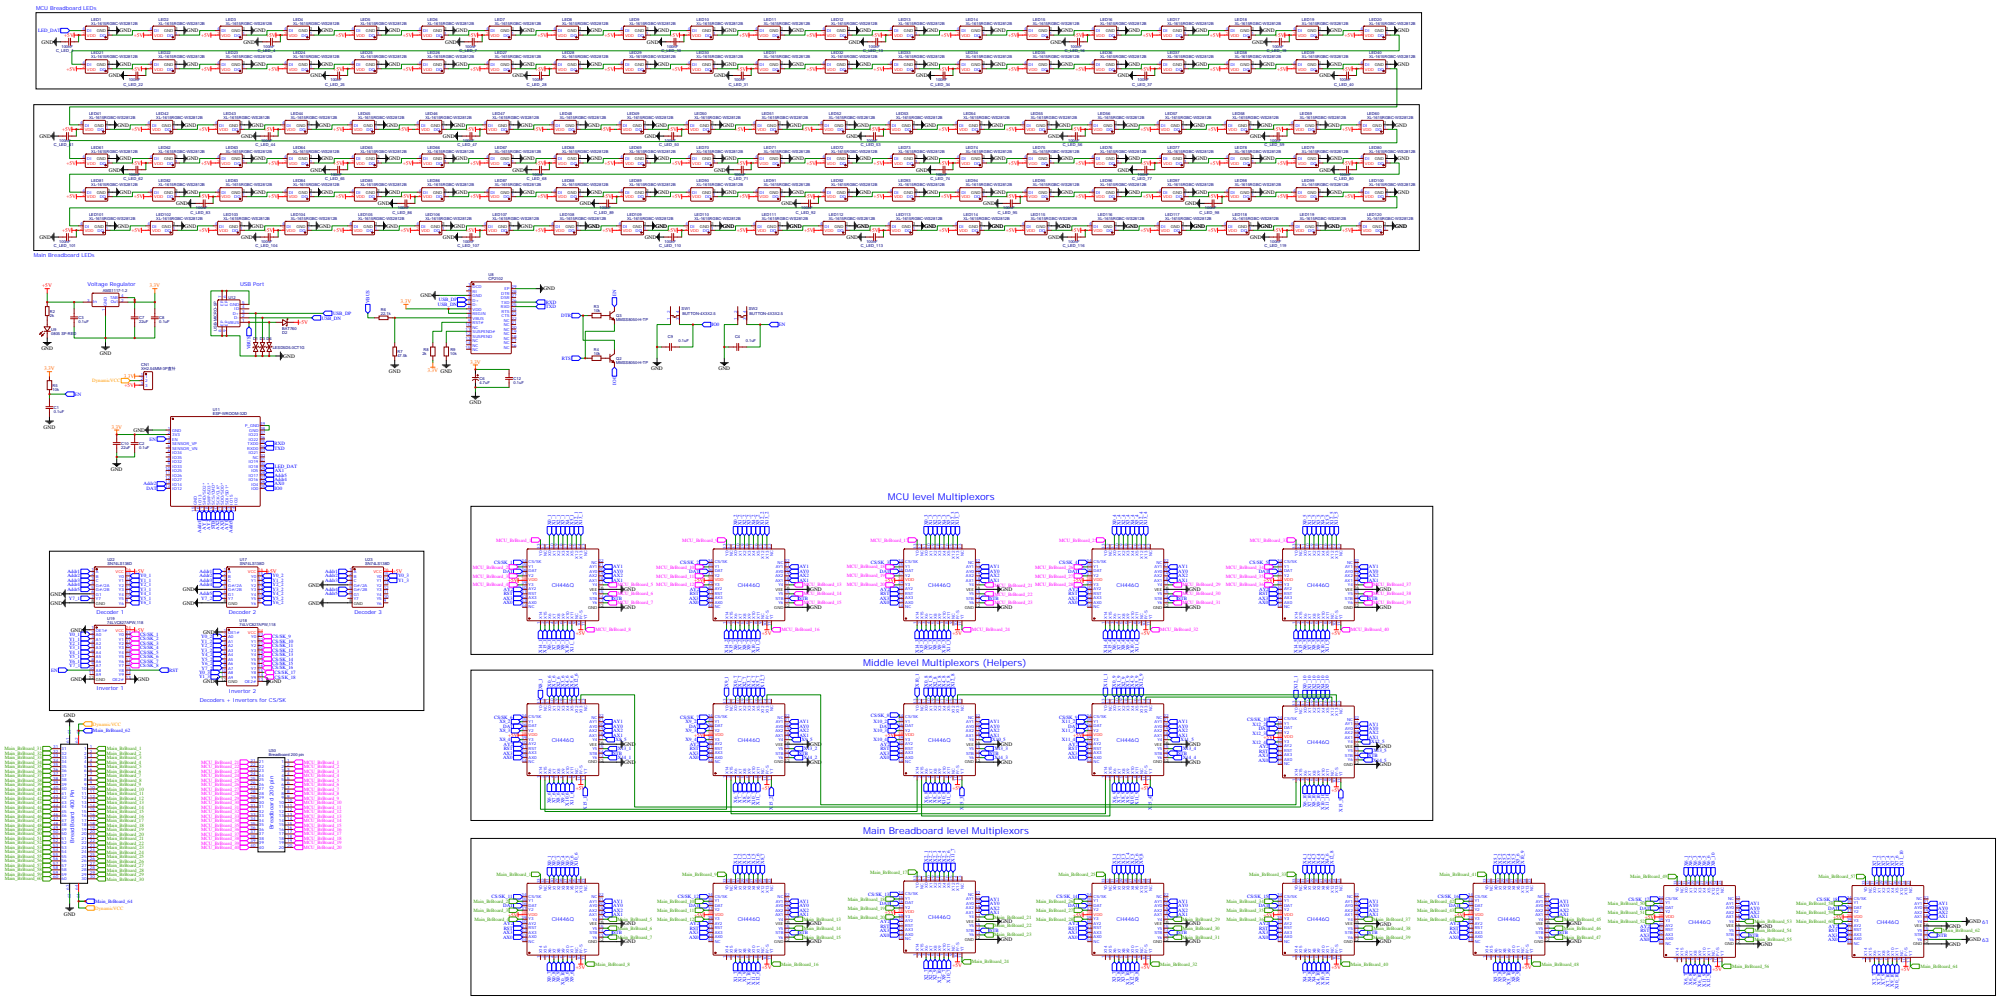
[picture p50: page 1]

Middle level Multiplexors (Helpers)

Decoders + Invertors for CS/SK

Main Breadboard level Multiplexors
