Ne-Se-Chete/CableUndefined-Embedded/Cable Undefined V1/PCB's/Mini PCB Demo TUES FEST/Schematic_CableUndefinedMini Rev2_2024-05-10.pdf

## MCU Breadboard LEDs

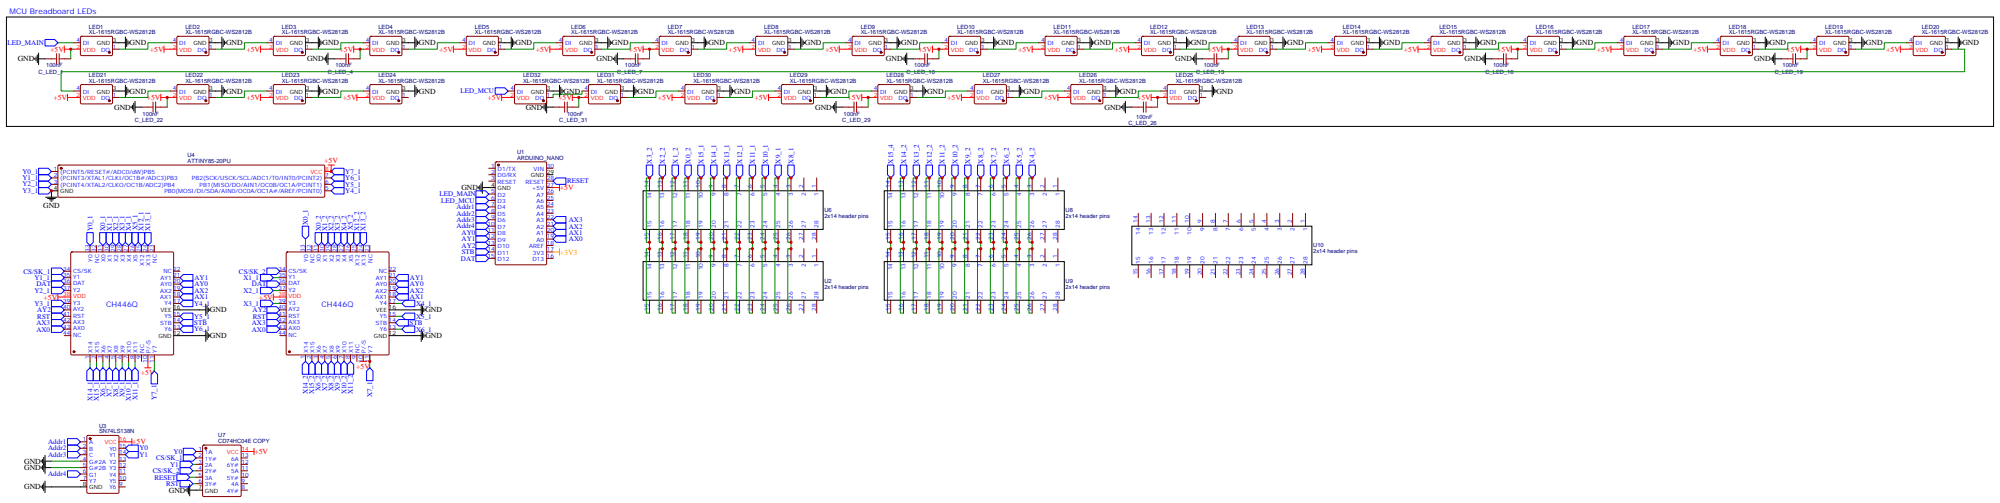
[picture p51: page 1]

PB0(MOSI/DI/SDA/AIN0/OC0A/OC1A#/AREF/PCINT0) 5

GND 12 Y6 13 STB 14 Y5 15 VEE 16 Y4 17 AX1 18 AX2 19 AY0 20 AY1 21 NC 22
