Ne-Se-Chete/CableUndefined-Embedded/Cable Undefined V1/PCB's/Mini PCB Demo TUES FEST/PCB_PCB_CableUndefinedMini_2 copy_2024-05-10.pdf

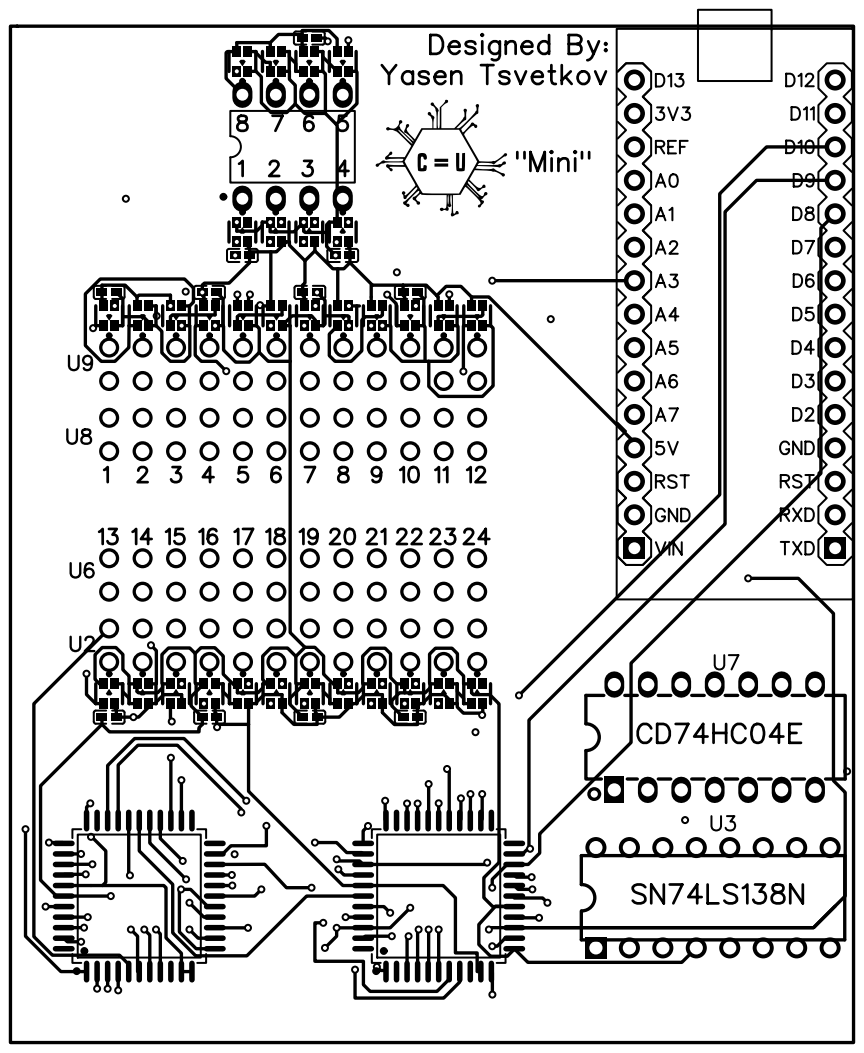
[picture p52: page 1]
