Ne-Se-Chete/CableUndefined-Embedded/Tests/TsvetelinMarinovHelp/CblUndef.asc

D2: schottky; RBR40NS60A
M1: nmos; IRF6623
M2: pmos; Si7137DP
M3: pmos; Si7137DP
M4: pmos; Si7137DP
M5: pmos; Si7137DP
M6: pmos; Si7137DP
M7: nmos; IRF6623
M8: nmos; IRF6623
M10: nmos; IRF6623
R1: res; 100k
R2: res; 100k
R3: res; 100k
R4: res; 100k
R5: res; 4.7k
R6: res; 100k
R7: res; 1.5k
R8: res; 100k
R9: res; 1.5k
R10: res; 100
R14: res; 470k
R16: res; 100k
R18: res; 100k
R19: res; 100
R21: res; 100
R22: res; 100
R23: res; 100
R24: res; 100
R25: res; 1Meg
RLOAD_DN: res; 10
RLOAD_UP: res; 1
V1: voltage; 3.3
V2: voltage; 5
V3: voltage; PULSE(0 3.3 0 10n 10n 20u 40u)
V4: voltage; PULSE(0 3.3 0 10n 10n 20u 40u)
V5: voltage; PULSE(0 5 0 10n 10n 20u 40u)
Named nets: 0, 3.3V, 5V, EN_GND, MAIN_BUS, PORTFC, EN_5V_logic, EN_3V3_logic, EN_3V3, EN_5V, EN
Active 1
Voltage sources
Port BB
.tran 0.1m
Active 1
Active 1
Level shifter
Port of FPGA
Look up table
Power: GND
EN_5V_logic
EN_3V3_logic
EN_3V3
EN_5V
EN_GND
PORTFC
Power: 3V3
Power: 5V
Logic 3V3
Logic 5V
0
0
0
0
1
HI-Z
0 = 0V
1 = 3.3V
Works !
Active 1
Active 1
Active 1
Active 1
Active 1
Works !
0
0
0
1
0
HI-Z
0
0
1
0
0
HI-Z
Works !
0
1
0
0
0
Input or output
Works, but with some issues !
1
0
0
0
0
Input or output
Works, but with some issues !
