Ne-Se-Chete/CableUndefined-Embedded/Tests/TsvetelinMarinovHelp/PMOS.asc

M1: pmos; Si7137DP
R1: res; 10k
R2: res; 1k
R3: res; 10
V1: voltage; 3.3
Named nets: 0, VCC_3V3
.tran 0.1
