Ne-Se-Chete/CableUndefined-Embedded/(list of files, drawings)

Other design files:
Cable Undefined V1/PCB's/Mini PCB Demo TUES FEST/PCB_CableUndefinedMini_Rev2.json
Cable Undefined V1/Python13May/SCH_CableUndefinedMini Rev2_2024-05-01.json
