Ne-Se-Chete/CableUndefined-Embedded/Cable Undefined V1/PCB's/Main PCB/PCB_CableUndefined1stPrototype_2024-02-18.kicad_pcb

## KiCad design Cable Undefined V1/PCB's/Main PCB/PCB_CableUndefined1stPrototype_2024-02-18.kicad_pcb (2024-02-28, an earlier design)

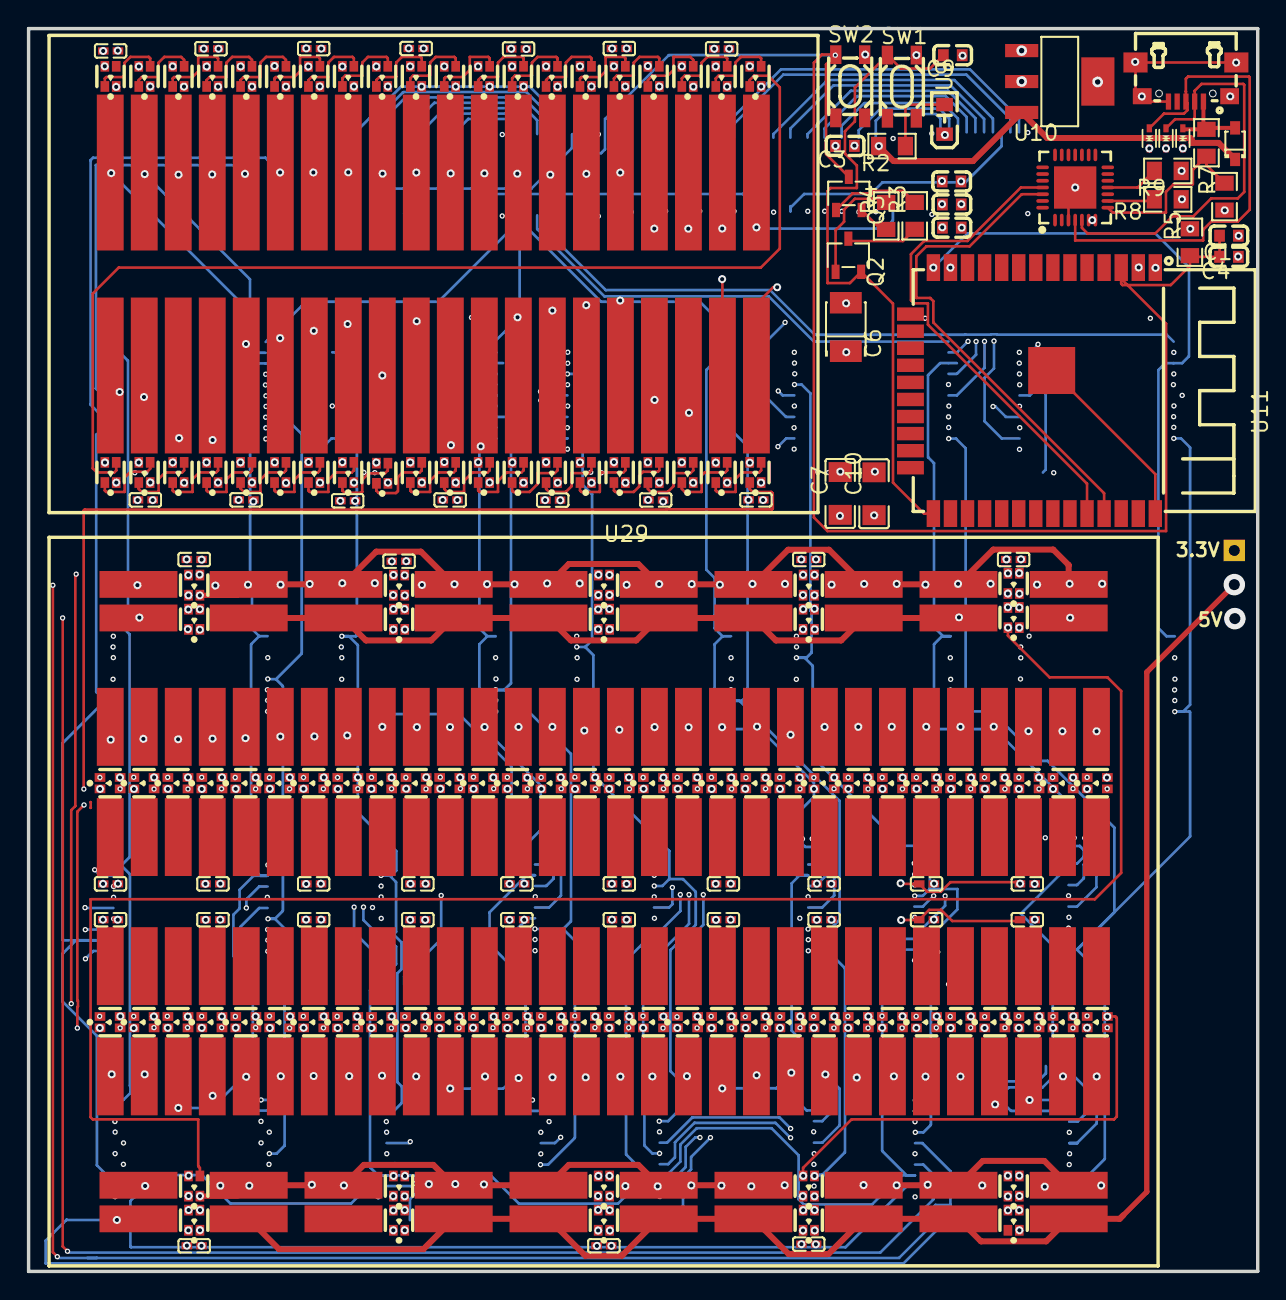
[picture p53: board PCB_CableUndefined1stPrototype_2024-02-18.kicad_pcb from above]

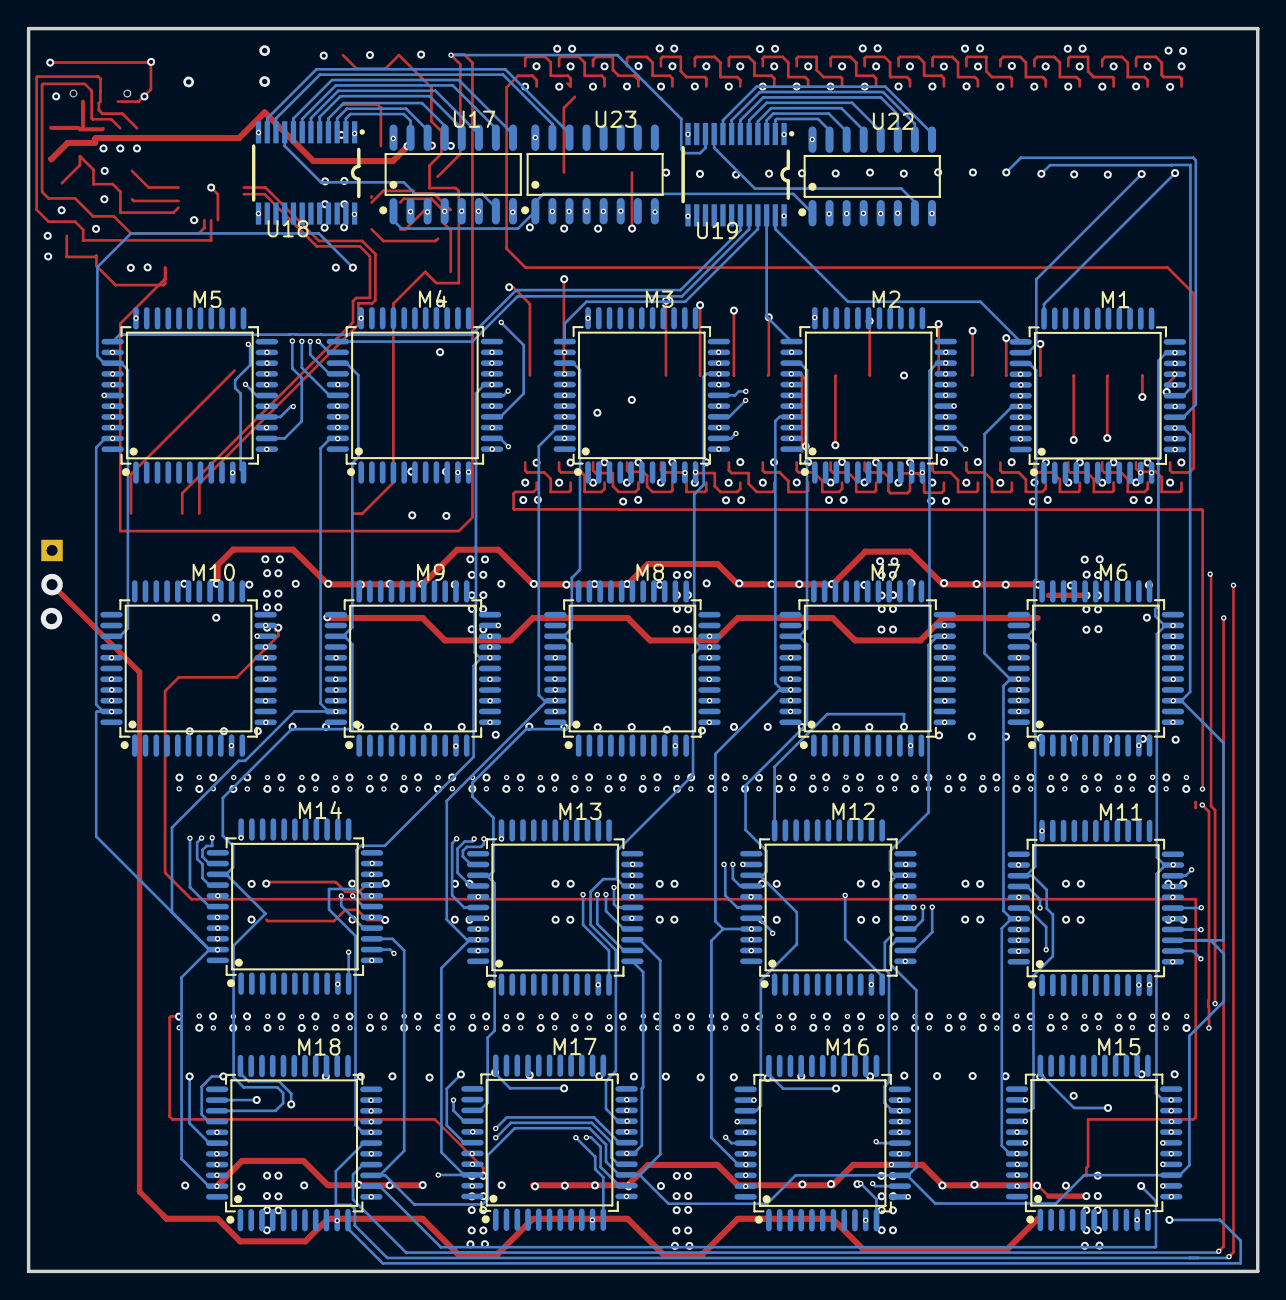
[picture p54: board PCB_CableUndefined1stPrototype_2024-02-18.kicad_pcb from below]

Board: 6 copper layers, 91.4 x 92.5 mm, 217 parts (22 on the bottom side), 445 nets.

Parts:
C1, C2, C3, C4, C8, C9, C12: 0.1uF; C0603
C6: 4.7uF; CAP-SMD_L3.5-W2.8
C7, C10: 22uF; C1206
C_LED_1, C_LED_4, C_LED_7, C_LED_10, C_LED_13, C_LED_16, C_LED_19, C_LED_22, C_LED_25, C_LED_28, C_LED_31, C_LED_34, C_LED_37, C_LED_40, C_LED_41, C_LED_44, C_LED_47, C_LED_50, C_LED_53, C_LED_56, C_LED_59, C_LED_62, C_LED_65, C_LED_68, C_LED_71, C_LED_74, C_LED_77, C_LED_80, C_LED_83, C_LED_86, C_LED_89, C_LED_92, C_LED_95, C_LED_98, C_LED_101, C_LED_104, C_LED_107, C_LED_110, C_LED_113, C_LED_116, C_LED_119: 100nF; C0402
D1, D3, D4: LESD5D5.0CT1G; SOD-523_L1.2-W0.8-LS1.6-BI
D2: BAT760; SOD-323_L1.8-W1.3-LS2.5-RD
LED1, LED2, LED3, LED4, LED5, LED6, LED7, LED8, LED9, LED10, LED11, LED12, LED13, LED14, LED15, LED16, LED17, LED18, LED19, LED20, LED21, LED22, LED23, LED24, LED25, LED26, LED27, LED28, LED29, LED30, LED31, LED32, LED33, LED34, LED35, LED36, LED37, LED38, LED39, LED40, LED41, LED42, LED43, LED44, LED45, LED46, LED47, LED48, LED49, LED50, LED51, LED52, LED53, LED54, LED55, LED56, LED57, LED58, LED59, LED60, LED61, LED62, LED63, LED64, LED65, LED66, LED67, LED68, LED69, LED70, LED71, LED72, LED73, LED74, LED75, LED76, LED77, LED78, LED79, LED80, LED81, LED82, LED83, LED84, LED85, LED86, LED87, LED88, LED89, LED90, LED91, LED92, LED93, LED94, LED95, LED96, LED97, LED98, LED99, LED100, LED101, LED102, LED103, LED104, LED105, LED106, LED107, LED108, LED109, LED110, LED111, LED112, LED113, LED114, LED115, LED116, LED117, LED118, LED119, LED120: XL-1615RGBC-WS2812B; LED-SMD_4P-L1.6-W1.5_XL-1615RGBC-WS2812B
M1, M2, M3, M4, M5, M6, M7, M8, M9, M10, M11, M12, M13, M14, M15, M16, M17, M18: CH446Q; LQFP-44_L10.0-W10.0-P0.80-LS12.0-BL
Q2, Q3: MMSS8050-H-TP; SOT-23-3_L2.9-W1.6-P1.90-LS2.8-BR
R2, R8: 2kΩ; R0805
R3, R4, R5, R9: 10kΩ; R0805
R6: 22.1kΩ; R0805
R7: 47.5kΩ; R0805
SW1, SW2: BUTTON-4X3X2.5; SW-SMD_4P-L4.2-W3.2-P2.15-LS5.2
U8: CP2102; QFN-28_L5.0-W5.0-P0.50-TL-EP3.2
U9: 0805 SF-RED; LED0805-RD_RED
U10: AMS1117-1.2; SOT-223-4_L6.5-W3.5-P2.30-LS7.0-BR
U11: ESP-WROOM-32D; COMM-SMD_ESP-WROOM-32D
U12: USB-MICRO-5P; MICRO-USB-SMD_MICRO-USB-A9
U17, U22, U23: SN74LS138D; SOIC-16_L9.9-W3.9-P1.27-LS6.0-BL
U18, U19: 74LVC827APW,118; TSSOP-24_L7.8-W4.4-P0.65-LS6.4-BL
U29: Breadboard400Pin; BREADBOARD 400 POINT
U30: Breadboard 200 pin; BREADBOARD 200 PIN

Connections:
3.3V: C2.2, C6.1, C7.2, C8.2, C10.2, C12.2, R5.2, R8.1, U8.6, U8.7, U10.2, U10.4, U11.2
+5V: C3.2, C_LED_1.1, C_LED_4.1, C_LED_7.1, C_LED_10.1, C_LED_13.1, C_LED_16.1, C_LED_19.1, C_LED_22.1, C_LED_25.1, C_LED_28.1, C_LED_31.1, C_LED_34.1, C_LED_37.1, C_LED_40.1, C_LED_41.1, C_LED_44.1, C_LED_47.1, C_LED_50.1, C_LED_53.1, C_LED_56.1, C_LED_59.1, C_LED_62.1, C_LED_65.1, C_LED_68.1, C_LED_71.1, C_LED_74.1, C_LED_77.1, C_LED_80.1, C_LED_83.1, C_LED_86.1, C_LED_89.1, C_LED_92.1, C_LED_95.1, C_LED_98.1, C_LED_101.1, C_LED_104.1, C_LED_107.1, C_LED_110.1, C_LED_113.1, C_LED_116.1, C_LED_119.1, D2.1, LED1.2, LED2.2, LED3.2, LED4.2, LED5.2, LED6.2, LED7.2, LED8.2, LED9.2, LED10.2, LED11.2, LED12.2, LED13.2, LED14.2, LED15.2, LED16.2, LED17.2, LED18.2, LED19.2, LED20.2, LED21.2, LED22.2, LED23.2, LED24.2, LED25.2, LED26.2, LED27.2, LED28.2, LED29.2, LED30.2, LED31.2, LED32.2, LED33.2, LED34.2, LED35.2, LED36.2, LED37.2, LED38.2, LED39.2, LED40.2, LED41.2, LED42.2, LED43.2, LED44.2, LED45.2, LED46.2, LED47.2, LED48.2, LED49.2, LED50.2, LED51.2, LED52.2, LED53.2, LED54.2, LED55.2, LED56.2, LED57.2, LED58.2, LED59.2, LED60.2, LED61.2, LED62.2, LED63.2, LED64.2, LED65.2, LED66.2, LED67.2, LED68.2, LED69.2, LED70.2, LED71.2, LED72.2, LED73.2, LED74.2, LED75.2, LED76.2, LED77.2, LED78.2, LED79.2, LED80.2, LED81.2, LED82.2, LED83.2, LED84.2, LED85.2, LED86.2, LED87.2, LED88.2, LED89.2, LED90.2, LED91.2, LED92.2, LED93.2, LED94.2, LED95.2, LED96.2, LED97.2, LED98.2, LED99.2, LED100.2, LED101.2, LED102.2, LED103.2, LED104.2, LED105.2, LED106.2, LED107.2, LED108.2, LED109.2, LED110.2, LED111.2, LED112.2, LED113.2, LED114.2, LED115.2, LED116.2, LED117.2, LED118.2, LED119.2, LED120.2, M1.10, M1.38, M2.10, M2.38, M3.10, M3.38, M4.10, M4.38, M5.10, M5.38, M6.10, M6.38, M7.10, M7.38, M8.10, M8.38, M9.10, M9.38, M10.10, M10.38, M11.10, M11.38, M12.10, M12.38, M13.10, M13.38, M14.10, M14.38, M15.10, M15.38, M16.10, M16.38, M17.10, M17.38, M18.10, M18.38, R2.2, U10.3, U17.16, U18.24, U19.24, U22.16, U23.16
ADDR1: U11.16, U17.1, U22.1, U23.1
ADDR2: U11.13, U17.2, U22.2, U23.2
ADDR3: U11.23, U17.3, U22.3, U23.3
ADDR4: U11.27, U17.4, U22.4, U23.5
ADDR5: U11.28, U17.6, U22.5, U23.6
AX0: M1.43, M2.43, M3.43, M4.43, M5.43, M6.43, M7.43, M8.43, M9.43, M10.43, M11.43, M12.43, M13.43, M14.43, M15.43, M16.43, M17.43, M18.43, U11.26
AX1: M1.18, M2.18, M3.18, M4.18, M5.18, M6.18, M7.18, M8.18, M9.18, M10.18, M11.18, M12.18, M13.18, M14.18, M15.18, M16.18, M17.18, M18.18, U11.29
AX2: M1.19, M2.19, M3.19, M4.19, M5.19, M6.19, M7.19, M8.19, M9.19, M10.19, M11.19, M12.19, M13.19, M14.19, M15.19, M16.19, M17.19, M18.19, U11.20
AX3: M1.42, M2.42, M3.42, M4.42, M5.42, M6.42, M7.42, M8.42, M9.42, M10.42, M11.42, M12.42, M13.42, M14.42, M15.42, M16.42, M17.42, M18.42, U11.21
AY0: M1.20, M2.20, M3.20, M4.20, M5.20, M6.20, M7.20, M8.20, M9.20, M10.20, M11.20, M12.20, M13.20, M14.20, M15.20, M16.20, M17.20, M18.20, U11.22
AY1: M1.21, M2.21, M3.21, M4.21, M5.21, M6.21, M7.21, M8.21, M9.21, M10.21, M11.21, M12.21, M13.21, M14.21, M15.21, M16.21, M17.21, M18.21, U11.17
AY2: M1.40, M2.40, M3.40, M4.40, M5.40, M6.40, M7.40, M8.40, M9.40, M10.40, M11.40, M12.40, M13.40, M14.40, M15.40, M16.40, M17.40, M18.40, U11.18
CS/SK_1: M1.34, U19.23
CS/SK_2: M2.34, U19.22
CS/SK_3: M3.34, U19.21
CS/SK_4: M4.34, U19.20
CS/SK_5: M5.34, U19.19
CS/SK_6: M6.34, U19.18
CS/SK_7: M7.34, U19.17
CS/SK_8: M8.34, U19.16
CS/SK_9: M9.34, U18.23
CS/SK_10: M10.34, U18.22
CS/SK_11: M11.34, U18.21
CS/SK_12: M12.34, U18.20
CS/SK_13: M13.34, U18.19
CS/SK_14: M14.34, U18.18
CS/SK_15: M15.34, U18.17
CS/SK_16: M16.34, U18.16
CS/SK_17: M17.34, U18.15
CS/SK_18: M18.34, U18.14
DAT: M1.36, M2.36, M3.36, M4.36, M5.36, M6.36, M7.36, M8.36, M9.36, M10.36, M11.36, M12.36, M13.36, M14.36, M15.36, M16.36, M17.36, M18.36, U11.14
DTR: Q2.3, R3.1
EN: C1.1, C4.1, Q3.3, R5.1, SW2.3, U11.3, U19.10
GND: C1.2, C2.1, C3.1, C4.2, C6.2, C7.1, C8.1, C9.2, C10.1, C12.1, C_LED_1.2, C_LED_4.2, C_LED_7.2, C_LED_10.2, C_LED_13.2, C_LED_16.2, C_LED_19.2, C_LED_22.2, C_LED_25.2, C_LED_28.2, C_LED_31.2, C_LED_34.2, C_LED_37.2, C_LED_40.2, C_LED_41.2, C_LED_44.2, C_LED_47.2, C_LED_50.2, C_LED_53.2, C_LED_56.2, C_LED_59.2, C_LED_62.2, C_LED_65.2, C_LED_68.2, C_LED_71.2, C_LED_74.2, C_LED_77.2, C_LED_80.2, C_LED_83.2, C_LED_86.2, C_LED_89.2, C_LED_92.2, C_LED_95.2, C_LED_98.2, C_LED_101.2, C_LED_104.2, C_LED_107.2, C_LED_110.2, C_LED_113.2, C_LED_116.2, C_LED_119.2, D1.1, D3.1, D4.1, LED1.3, LED2.3, LED3.3, LED4.3, LED5.3, LED6.3, LED7.3, LED8.3, LED9.3, LED10.3, LED11.3, LED12.3, LED13.3, LED14.3, LED15.3, LED16.3, LED17.3, LED18.3, LED19.3, LED20.3, LED21.3, LED22.3, LED23.3, LED24.3, LED25.3, LED26.3, LED27.3, LED28.3, LED29.3, LED30.3, LED31.3, LED32.3, LED33.3, LED34.3, LED35.3, LED36.3, LED37.3, LED38.3, LED39.3, LED40.3, LED41.3, LED42.3, LED43.3, LED44.3, LED45.3, LED46.3, LED47.3, LED48.3, LED49.3, LED50.3, LED51.3, LED52.3, LED53.3, LED54.3, LED55.3, LED56.3, LED57.3, LED58.3, LED59.3, LED60.3, LED61.3, LED62.3, LED63.3, LED64.3, LED65.3, LED66.3, LED67.3, LED68.3, LED69.3, LED70.3, LED71.3, LED72.3, LED73.3, LED74.3, LED75.3, LED76.3, LED77.3, LED78.3, LED79.3, LED80.3, LED81.3, LED82.3, LED83.3, LED84.3, LED85.3, LED86.3, LED87.3, LED88.3, LED89.3, LED90.3, LED91.3, LED92.3, LED93.3, LED94.3, LED95.3, LED96.3, LED97.3, LED98.3, LED99.3, LED100.3, LED101.3, LED102.3, LED103.3, LED104.3, LED105.3, LED106.3, LED107.3, LED108.3, LED109.3, LED110.3, LED111.3, LED112.3, LED113.3, LED114.3, LED115.3, LED116.3, LED117.3, LED118.3, LED119.3, LED120.3, M1.12, M1.16, M2.12, M2.16, M3.12, M3.16, M4.12, M4.16, M5.12, M5.16, M6.12, M6.16, M7.12, M7.16, M8.12, M8.16, M9.12, M9.16, M10.12, M10.16, M11.12, M11.16, M12.12, M12.16, M13.12, M13.16, M14.12, M14.16, M15.12, M15.16, M16.12, M16.16, M17.12, M17.16, M18.12, M18.16, R7.1, R9.1, SW1.1, SW2.1, U8.3, U8.29, U9.1, U10.1, U11.1, U12.5, U12.6, U12.7, U12.8, U12.9, U17.5, U17.8, U18.1, U18.12, U18.13, U19.1, U19.12, U19.13, U22.6, U22.8, U23.4, U23.8, U29.NC
IO0: C9.1, Q2.2, SW1.3, U11.25
LED1_1: LED1.1, LED2.4
LED2_1: LED2.1, LED3.4
LED3_1: LED3.1, LED4.4
LED4_1: LED4.1, LED5.4
LED5_1: LED5.1, LED6.4
LED6_1: LED6.1, LED7.4
LED7_1: LED7.1, LED8.4
LED8_1: LED8.1, LED9.4
LED9_1: LED9.1, LED10.4
LED10_1: LED10.1, LED11.4
LED11_1: LED11.1, LED12.4
LED12_1: LED12.1, LED13.4
LED13_1: LED13.1, LED14.4
LED14_1: LED14.1, LED15.4
LED15_1: LED15.1, LED16.4
LED16_1: LED16.1, LED17.4
LED17_1: LED17.1, LED18.4
LED18_1: LED18.1, LED19.4
LED19_1: LED19.1, LED20.4
LED20_1: LED20.1, LED21.4
LED21_1: LED21.1, LED22.4
LED22_1: LED22.1, LED23.4
LED23_1: LED23.1, LED24.4
LED24_1: LED24.1, LED25.4
LED25_1: LED25.1, LED26.4
LED26_1: LED26.1, LED27.4
LED27_1: LED27.1, LED28.4
LED28_1: LED28.1, LED29.4
LED29_1: LED29.1, LED30.4
LED30_1: LED30.1, LED31.4
LED31_1: LED31.1, LED32.4
LED32_1: LED32.1, LED33.4
LED33_1: LED33.1, LED34.4
LED34_1: LED34.1, LED35.4
LED35_1: LED35.1, LED36.4
LED36_1: LED36.1, LED37.4
LED37_1: LED37.1, LED38.4
LED38_1: LED38.1, LED39.4
LED39_1: LED39.1, LED40.4
LED40_1: LED40.1, LED41.4
LED41_1: LED41.1, LED42.4
LED42_1: LED42.1, LED43.4
LED43_1: LED43.1, LED44.4
LED44_1: LED44.1, LED45.4
LED45_1: LED45.1, LED46.4
LED46_1: LED46.1, LED47.4
LED47_1: LED47.1, LED48.4
LED48_1: LED48.1, LED49.4
LED49_1: LED49.1, LED50.4
LED50_1: LED50.1, LED51.4
LED51_1: LED51.1, LED52.4
LED52_1: LED52.1, LED53.4
LED53_1: LED53.1, LED54.4
LED54_1: LED54.1, LED55.4
LED55_1: LED55.1, LED56.4
LED56_1: LED56.1, LED57.4
LED57_1: LED57.1, LED58.4
LED58_1: LED58.1, LED59.4
LED59_1: LED59.1, LED60.4
LED60_1: LED60.1, LED61.4
LED62_4: LED61.1, LED62.4
LED63_4: LED62.1, LED63.4
LED64_4: LED63.1, LED64.4
LED65_4: LED64.1, LED65.4
LED66_4: LED65.1, LED66.4
LED67_4: LED66.1, LED67.4
LED68_4: LED67.1, LED68.4
LED69_4: LED68.1, LED69.4
LED70_4: LED69.1, LED70.4
LED71_4: LED70.1, LED71.4
LED72_4: LED71.1, LED72.4
LED73_4: LED72.1, LED73.4
LED74_4: LED73.1, LED74.4
LED75_4: LED74.1, LED75.4
LED76_4: LED75.1, LED76.4
LED77_4: LED76.1, LED77.4
LED78_4: LED77.1, LED78.4
LED79_4: LED78.1, LED79.4
LED80_4: LED79.1, LED80.4
LED81_4: LED80.1, LED81.4
LED82_4: LED81.1, LED82.4
LED83_4: LED82.1, LED83.4
LED84_4: LED83.1, LED84.4
LED85_4: LED84.1, LED85.4
LED86_4: LED85.1, LED86.4
LED87_4: LED86.1, LED87.4
LED88_4: LED87.1, LED88.4
LED89_4: LED88.1, LED89.4
LED90_4: LED89.1, LED90.4
LED91_4: LED90.1, LED91.4
LED92_4: LED91.1, LED92.4
LED93_4: LED92.1, LED93.4
LED94_4: LED93.1, LED94.4
LED95_4: LED94.1, LED95.4
LED96_4: LED95.1, LED96.4
LED97_4: LED96.1, LED97.4
LED98_4: LED97.1, LED98.4
LED99_4: LED98.1, LED99.4
LED100_1: LED100.1, LED101.4
LED100_4: LED99.1, LED100.4
LED102_4: LED101.1, LED102.4
LED103_1: LED103.1, LED104.4
LED103_4: LED102.1, LED103.4
LED104_1: LED104.1, LED105.4
LED105_1: LED105.1, LED106.4
LED106_1: LED106.1, LED107.4
LED107_1: LED107.1, LED108.4
LED108_1: LED108.1, LED109.4
LED109_1: LED109.1, LED110.4
LED110_1: LED110.1, LED111.4
LED111_1: LED111.1, LED112.4
LED112_1: LED112.1, LED113.4
LED113_1: LED113.1, LED114.4
LED114_1: LED114.1, LED115.4
LED115_1: LED115.1, LED116.4
LED116_1: LED116.1, LED117.4
LED117_1: LED117.1, LED118.4
LED118_1: LED118.1, LED119.4
LED119_1: LED119.1, LED120.4
M6_1: M6.1, M7.1
M6_2: M6.2, M8.1
M6_24: M6.24, M10.2
M9_1: M7.2, M9.1
M9_2: M8.2, M9.2
M10_1: M7.24, M10.1
M10_24: M8.24, M10.24
M10_25: M9.24, M10.25
MAIN_BRBOARD_1: M11.33, U29.1
MAIN_BRBOARD_2: M11.35, U29.2
MAIN_BRBOARD_3: M11.37, U29.3
MAIN_BRBOARD_4: M11.39, U29.4
MAIN_BRBOARD_5: M11.17, U29.5
MAIN_BRBOARD_6: M11.15, U29.6
MAIN_BRBOARD_7: M11.13, U29.7
MAIN_BRBOARD_8: M11.11, U29.8
MAIN_BRBOARD_9: M12.33, U29.9
MAIN_BRBOARD_10: M12.35, U29.10
MAIN_BRBOARD_11: M12.37, U29.11
MAIN_BRBOARD_12: M12.39, U29.12
MAIN_BRBOARD_13: M12.17, U29.13
MAIN_BRBOARD_14: M12.15, U29.14
MAIN_BRBOARD_15: M12.13, U29.15
MAIN_BRBOARD_16: M12.11, U29.16
MAIN_BRBOARD_17: M13.33, U29.17
MAIN_BRBOARD_18: M13.35, U29.18
MAIN_BRBOARD_19: M13.37, U29.19
MAIN_BRBOARD_20: M13.39, U29.20
MAIN_BRBOARD_21: M13.17, U29.21
MAIN_BRBOARD_22: M13.15, U29.22
MAIN_BRBOARD_23: M13.13, U29.23
MAIN_BRBOARD_24: M13.11, U29.24
MAIN_BRBOARD_25: M14.33, U29.25
MAIN_BRBOARD_26: M14.35, U29.26
MAIN_BRBOARD_27: M14.37, U29.27
MAIN_BRBOARD_28: M14.39, U29.28
MAIN_BRBOARD_29: M14.17, U29.29
MAIN_BRBOARD_30: M14.15, U29.30
MAIN_BRBOARD_31: M14.13, U29.31
MAIN_BRBOARD_32: M14.11, U29.32
MAIN_BRBOARD_33: M15.33, U29.33
MAIN_BRBOARD_34: M15.35, U29.34
MAIN_BRBOARD_35: M15.37, U29.35
MAIN_BRBOARD_36: M15.39, U29.36
MAIN_BRBOARD_37: M15.17, U29.37
MAIN_BRBOARD_38: M15.15, U29.38
MAIN_BRBOARD_39: M15.13, U29.39
MAIN_BRBOARD_40: M15.11, U29.40
MAIN_BRBOARD_41: M16.33, U29.41
MAIN_BRBOARD_42: M16.35, U29.42
MAIN_BRBOARD_43: M16.37, U29.43
MAIN_BRBOARD_44: M16.39, U29.44
MAIN_BRBOARD_45: M16.17, U29.45
MAIN_BRBOARD_46: M16.15, U29.46
MAIN_BRBOARD_47: M16.13, U29.47
MAIN_BRBOARD_48: M16.11, U29.48
MAIN_BRBOARD_49: M17.33, U29.49
MAIN_BRBOARD_50: M17.35, U29.50
MAIN_BRBOARD_51: M17.37, U29.51
MAIN_BRBOARD_52: M17.39, U29.52
MAIN_BRBOARD_53: M17.17, U29.53
MAIN_BRBOARD_54: M17.15, U29.54
MAIN_BRBOARD_55: M17.13, U29.55
MAIN_BRBOARD_56: M17.11, U29.56
MAIN_BRBOARD_57: M18.33, U29.57
MAIN_BRBOARD_58: M18.35, U29.58
MAIN_BRBOARD_59: M18.37, U29.59
MAIN_BRBOARD_60: M18.39, U29.60
MAIN_BRBOARD_61: M18.17, U29.61
MAIN_BRBOARD_62: M18.15, U29.62
MAIN_BRBOARD_63: M18.13, U29.63
MAIN_BRBOARD_64: M18.11, U29.64
MCU_BRBOARD_1: M1.33, U30.1
MCU_BRBOARD_2: M1.35, U30.2
MCU_BRBOARD_3: M1.37, U30.3
MCU_BRBOARD_4: M1.39, U30.4
MCU_BRBOARD_5: M1.17, U30.5
MCU_BRBOARD_6: M1.15, U30.6
MCU_BRBOARD_7: M1.13, U30.7
MCU_BRBOARD_8: M1.11, U30.8
MCU_BRBOARD_9: M2.33, U30.9
MCU_BRBOARD_10: M2.35, U30.10
MCU_BRBOARD_11: M2.37, U30.11
MCU_BRBOARD_12: M2.39, U30.12
MCU_BRBOARD_13: M2.17, U30.13
MCU_BRBOARD_14: M2.15, U30.14
MCU_BRBOARD_15: M2.13, U30.15
MCU_BRBOARD_16: M2.11, U30.16
MCU_BRBOARD_17: M3.33, U30.17
MCU_BRBOARD_18: M3.35, U30.18
MCU_BRBOARD_19: M3.37, U30.19
MCU_BRBOARD_20: M3.39, U30.20
MCU_BRBOARD_21: M3.17, U30.21
MCU_BRBOARD_22: M3.15, U30.22
MCU_BRBOARD_23: M3.13, U30.23
MCU_BRBOARD_24: M3.11, U30.24
MCU_BRBOARD_25: M4.33, U30.25
MCU_BRBOARD_26: M4.35, U30.26
MCU_BRBOARD_27: M4.37, U30.27
MCU_BRBOARD_28: M4.39, U30.28
MCU_BRBOARD_29: M4.17, U30.29
MCU_BRBOARD_30: M4.15, U30.30
MCU_BRBOARD_31: M4.13, U30.31
MCU_BRBOARD_32: M4.11, U30.32
MCU_BRBOARD_33: M5.33, U30.33
MCU_BRBOARD_34: M5.35, U30.34
MCU_BRBOARD_35: M5.37, U30.35
MCU_BRBOARD_36: M5.39, U30.36
MCU_BRBOARD_37: M5.17, U30.37
MCU_BRBOARD_38: M5.15, U30.38
MCU_BRBOARD_39: M5.13, U30.39
MCU_BRBOARD_40: M5.11, U30.40
Q3_1: Q3.1, R3.2
R2_1: R2.1, U9.2
R4_2: Q2.1, R4.2
RST: M1.41, M2.41, M3.41, M4.41, M5.41, M6.41, M7.41, M8.41, M9.41, M10.41, M11.41, M12.41, M13.41, M14.41, M15.41, M16.41, M17.41, M18.41, U19.15
RTS: Q3.2, R4.1
RXD: U8.26, U11.35
STB: M1.14, M2.14, M3.14, M4.14, M5.14, M6.14, M7.14, M8.14, M9.14, M10.14, M11.14, M12.14, M13.14, M14.14, M15.14, M16.14, M17.14, M18.14, U11.19
TXD: U8.25, U11.34
U8_8: R6.2, R7.2, U8.8
U8_9: R8.2, U8.9
U8_11: R9.2, U8.11
U11_38: U11.38, U11.39
USB_DN: D3.2, U8.5, U12.2
USB_DP: D1.2, U8.4, U12.3
VBUS: D2.2, D4.2, R6.1, U12.1
X0_1: M1.31, M11.31
X0_2: M2.31, M11.30
X0_3: M3.31, M11.29
X0_4: M4.31, M11.28
X0_5: M5.31, M11.27
X0_6: M6.31, M11.26
X0_7: M7.31, M11.3
X0_8: M8.31, M11.4
X0_9: M9.31, M11.5
X0_10: M10.31, M11.6
X1_1: M1.30, M12.31
X1_2: M2.30, M12.30
X1_3: M3.30, M12.29
X1_4: M4.30, M12.28
X1_5: M5.30, M12.27
X1_6: M6.30, M12.26
X1_7: M7.30, M12.3
X1_8: M8.30, M12.4
X1_9: M9.30, M12.5
X1_10: M10.30, M12.6
X2_1: M1.29, M13.31
X2_2: M2.29, M13.30
X2_3: M3.29, M13.29
X2_4: M4.29, M13.28
X2_5: M5.29, M13.27
X2_6: M6.29, M13.26
X2_7: M7.29, M13.3
X2_8: M8.29, M13.4
X2_9: M9.29, M13.5
X2_10: M10.29, M13.6
X3_1: M1.28, M14.31
X3_2: M2.28, M14.30
X3_3: M3.28, M14.29
X3_4: M4.28, M14.28
X3_5: M5.28, M14.27
X3_6: M6.28, M14.26
X3_7: M7.28, M14.3
X3_8: M8.28, M14.4
X3_9: M9.28, M14.5
X3_10: M10.28, M14.6
X4_1: M1.27, M15.31
X4_2: M2.27, M15.30
X4_3: M3.27, M15.29
X4_4: M4.27, M15.28
X4_5: M5.27, M15.27
X4_6: M6.27, M15.26
X4_7: M7.27, M15.3
X4_8: M8.27, M15.4
X4_9: M9.27, M15.5
X4_10: M10.27, M15.6
X5_1: M1.26, M16.31
X5_2: M2.26, M16.30
X5_3: M3.26, M16.29
X5_4: M4.26, M16.28
X5_5: M5.26, M16.27
X5_6: M6.26, M16.26
X5_7: M7.26, M16.3
X5_8: M8.26, M16.4
X5_9: M9.26, M16.5
X5_10: M10.26, M16.6
X6_1: M1.3, M17.31
X6_2: M2.3, M17.30
X6_3: M3.3, M17.29
X6_4: M4.3, M17.28
X6_5: M5.3, M17.27
X6_6: M6.3, M17.26
X6_7: M7.3, M17.3
X6_8: M8.3, M17.4
X6_9: M9.3, M17.5
X6_10: M10.3, M17.6
X7_1: M1.4, M18.31
X7_2: M2.4, M18.30
X7_3: M3.4, M18.29
X7_4: M4.4, M18.28
X7_5: M5.4, M18.27
X7_6: M6.4, M18.26
X7_7: M7.4, M18.3
X7_8: M8.4, M18.4
X7_9: M9.4, M18.5
X7_10: M10.4, M18.6
X8_1: M1.5, M6.33
X8_2: M2.5, M6.35
X8_3: M3.5, M6.37
X8_4: M4.5, M6.39
X8_5: M5.5, M6.17
X8_6: M6.5, M11.7
X8_7: M7.5, M12.25
X8_8: M8.5, M14.8
X8_9: M9.5, M16.7
X8_10: M10.5, M17.25
X9_1: M1.6, M7.33
X9_2: M2.6, M7.35
X9_3: M3.6, M7.37
X9_4: M4.6, M7.39
X9_5: M5.6, M7.17
X9_6: M6.6, M11.8
X9_7: M7.6, M13.7
X9_8: M8.6, M14.25
X9_9: M9.6, M16.8
X9_10: M10.6, M18.7
X10_1: M1.7, M8.33
X10_2: M2.7, M8.35
X10_3: M3.7, M8.37
X10_4: M4.7, M8.39
X10_5: M5.7, M8.17
X10_6: M6.7, M11.25
X10_7: M7.7, M13.8
X10_8: M8.7, M15.7
X10_9: M9.7, M16.25
X10_10: M10.7, M18.8
X11_1: M1.8, M9.33
X11_2: M2.8, M9.35
X11_3: M3.8, M9.37
X11_4: M4.8, M9.39
X11_5: M5.8, M9.17
X11_6: M6.8, M12.7
X11_7: M7.8, M13.25
X11_8: M8.8, M15.8
X11_9: M9.8, M17.7
X11_10: M10.8, M18.25
X12_1: M1.25, M10.33
X12_2: M2.25, M10.35
X12_3: M3.25, M10.37
X12_4: M4.25, M10.39
X12_5: M5.25, M10.17
X12_6: M6.25, M12.8
X12_7: M7.25, M14.7
X12_8: M8.25, M15.25
X12_9: M9.25, M17.8
X13_1: M1.24, M6.15
X13_2: M2.24, M7.15
X13_3: M3.24, M8.15
X13_4: M4.24, M9.15
X13_5: M5.24, M10.15
X14_1: M1.1, M6.13
X14_2: M2.1, M7.13
X14_3: M3.1, M8.13
X14_4: M4.1, M9.13
X14_5: M5.1, M10.13
X15_1: M1.2, M6.11
X15_2: M2.2, M7.11
X15_3: M3.2, M8.11
X15_4: M4.2, M9.11
X15_5: M5.2, M10.11
Y0_1: U19.2, U22.15
Y0_2: U17.15, U18.2
Y0_3: U18.10, U23.15
Y1_1: U19.3, U22.14
Y1_2: U17.14, U18.3
Y1_3: U18.11, U23.14
Y2_1: U19.4, U22.13
Y2_2: U17.13, U18.4
Y3_1: U19.5, U22.12
Y3_2: U17.12, U18.5
Y4_1: U19.6, U22.11
Y4_2: U17.11, U18.6
Y5_1: U19.7, U22.10
Y5_2: U17.10, U18.7
Y6_1: U19.8, U22.9
Y6_2: U17.9, U18.8
Y7_1: U19.9, U22.7
Y7_2: U17.7, U18.9
