Ne-Se-Chete/CableUndefined-Embedded/Cable Undefined V3/Core/Src/main.c

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
/* Includes ------------------------------------------------------------------*/
#include "main.h"

/* USER CODE BEGIN Includes */
#include "mux.h"
#include "serial.h"
#include "leds.h"
#include "signal_analyzer.h"
#include "fault.h"

#include <stdio.h>
#include <stdlib.h>

#include "stm32f1xx_ll_usart.h"
/* USER CODE END Includes */


void SystemClock_Config(void);
static void MX_GPIO_Init(void);
static void MX_DMA_Init(void);
static void MX_ADC1_Init(void);
static void MX_USART1_UART_Init(void);
static void MX_USART2_UART_Init(void);
static void MX_USART3_UART_Init(void);
static void MX_TIM6_Init(void);
static void MX_TIM2_Init(void);
/* USER CODE BEGIN 0 */

// Погледни чата с г-н Стефанов, _write e блокираща функция

int _write(int file, char *ptr, int len) {
    for (int i = 0; i < len; i++) {
        while (!LL_USART_IsActiveFlag_TXE(USART2));  // Wait until TX buffer is empty
        LL_USART_TransmitData8(USART2, ptr[i]);      // Send byte
    }

    while (!LL_USART_IsActiveFlag_TC(USART2));  // Wait for last transmission to complete
    return len;
}

/* USER CODE END 0 */

/**
  * @brief  The application entry point.
  * @retval int
  */
int main(void)
{

  /* MCU Configuration--------------------------------------------------------*/

  /* Reset of all peripherals, Initializes the Flash interface and the Systick. */
  LL_APB2_GRP1_EnableClock(LL_APB2_GRP1_PERIPH_AFIO);
  LL_APB1_GRP1_EnableClock(LL_APB1_GRP1_PERIPH_PWR);

  /* System interrupt init*/
  NVIC_SetPriorityGrouping(NVIC_PRIORITYGROUP_4);

  /* SysTick_IRQn interrupt configuration */
  NVIC_SetPriority(SysTick_IRQn, NVIC_EncodePriority(NVIC_GetPriorityGrouping(),15, 0));

  /** NOJTAG: JTAG-DP Disabled and SW-DP Enabled
  */
  LL_GPIO_AF_Remap_SWJ_NOJTAG();

  /* Configure the system clock */
  SystemClock_Config();

  /* Initialize all configured peripherals */
  MX_GPIO_Init();
  MX_DMA_Init();
  MX_ADC1_Init();
  MX_USART1_UART_Init();
  MX_USART2_UART_Init();
  MX_USART3_UART_Init();
  MX_TIM6_Init();
  MX_TIM2_Init();
  /* USER CODE BEGIN 2 */

  // Enable UART Interupts
  LL_USART_EnableIT_RXNE(USART1);
  LL_USART_EnableIT_RXNE(USART3);

  // Enable EXTI Fault GPIO Interrupts
  LL_EXTI_EnableIT_0_31(LL_EXTI_LINE_12);
  LL_EXTI_EnableIT_0_31(LL_EXTI_LINE_13);

  // Enable DMA Interrupt
  LL_DMA_EnableIT_TC(DMA1, LL_DMA_CHANNEL_5);

  LL_TIM_EnableCounter(TIM6);

  OscilloscopeInit();

  // Reset all Muxes
  LL_GPIO_SetOutputPin(RST_GPIO, RST_PIN);
  LL_mDelay(20);
  LL_GPIO_ResetOutputPin(RST_GPIO, RST_PIN);
  LL_mDelay(20);

  // Enable Protection
  LL_GPIO_SetOutputPin(PROTECTION_GPIO, PROTECTION_PIN);


  /* USER CODE END 2 */

  /* Infinite loop */
  /* USER CODE BEGIN WHILE */
	  while (1)
	  {
    /* USER CODE END WHILE */

    /* USER CODE BEGIN 3 */

		  sendSignalData();
		  FAULT_CheckAndReport();  // Only sends UART if a fault was detected


	  }
  /* USER CODE END 3 */
}

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
