Ne-Se-Chete/CableUndefined-Embedded/Cable Undefined V3/Core/Inc/mux_config.h

#ifndef MUXCONFIG_H
#define MUXCONFIG_H

// B_1 - B_8
const char* xPins1[16] = {"MT_1", "MT_2", "MT_3", "MT_4", "MT_5", "MT_6", "MT_7", "MT_8", "MT_9", "MT_10", "MT_11", "MT_12", "MT_13", "MT_14", "MT_15", "MT_16"};
const char* yPins1[8]  = {"B_1", "B_2", "B_3", "B_4", "B_5", "B_6", "B_7", "B_8"};

const char* xPins2[16] = {"MT_17", "MT_18", "MT_19", "MT_20", "MT_21", "MT_22", "MT_23", "MT_24", "MT_25", "MT_26", "MT_27", "MT_28", "MT_29", "MT_30", "MT_31", "MT_32"};
const char* yPins2[8]  = {"B_1", "B_2", "B_3", "B_4", "B_5", "B_6", "B_7", "B_8"};

// B_9 - B_16
const char* xPins3[16] = {"MT_1", "MT_2", "MT_3", "MT_4", "MT_5", "MT_6", "MT_7", "MT_8", "MT_9", "MT_10", "MT_11", "MT_12", "MT_13", "MT_14", "MT_15", "MT_16"};
const char* yPins3[8]  = {"B_9", "B_10", "B_11", "B_12", "B_13", "B_14", "B_15", "B_16"};

const char* xPins4[16] = {"MT_17", "MT_18", "MT_19", "MT_20", "MT_21", "MT_22", "MT_23", "MT_24", "MT_25", "MT_26", "MT_27", "MT_28", "MT_29", "MT_30", "MT_31", "MT_32"};
const char* yPins4[8]  = {"B_9", "B_10", "B_11", "B_12", "B_13", "B_14", "B_15", "B_16"};

// B_16 - B_24
const char* xPins5[16] = {"MT_1", "MT_2", "MT_3", "MT_4", "MT_5", "MT_6", "MT_7", "MT_8", "MT_9", "MT_10", "MT_11", "MT_12", "MT_13", "MT_14", "MT_15", "MT_16"};
const char* yPins5[8]  = {"B_17", "B_18", "B_19", "B_20", "B_21", "B_22", "B_23", "B_24"};

const char* xPins6[16] = {"MT_17", "MT_18", "MT_19", "MT_20", "MT_21", "MT_22", "MT_23", "MT_24", "MT_25", "MT_26", "MT_27", "MT_28", "MT_29", "MT_30", "MT_31", "MT_32"};
const char* yPins6[8]  = {"B_17", "B_18", "B_19", "B_20", "B_21", "B_22", "B_23", "B_24"};

// B_24 - B_32
const char* xPins7[16] = {"MT_1", "MT_2", "MT_3", "MT_4", "MT_5", "MT_6", "MT_7", "MT_8", "MT_9", "MT_10", "MT_11", "MT_12", "MT_13", "MT_14", "MT_15", "MT_16"};
const char* yPins7[8]  = {"B_25", "B_26", "B_27", "B_28", "B_29", "B_30", "B_31", "B_32"};

const char* xPins8[16] = {"MT_17", "MT_18", "MT_19", "MT_20", "MT_21", "MT_22", "MT_23", "MT_24", "MT_25", "MT_26", "MT_27", "MT_28", "MT_29", "MT_30", "MT_31", "MT_32"};
const char* yPins8[8]  = {"B_25", "B_26", "B_27", "B_28", "B_29", "B_30", "B_31", "B_32"};

// B_32 - B_40
const char* xPins9[16] = {"MT_1", "MT_2", "MT_3", "MT_4", "MT_5", "MT_6", "MT_7", "MT_8", "MT_9", "MT_10", "MT_11", "MT_12", "MT_13", "MT_14", "MT_15", "MT_16"};
const char* yPins9[8]  = {"B_33", "B_34", "B_35", "B_36", "B_37", "B_38", "B_39", "B_40"};

const char* xPins10[16] = {"MT_17", "MT_18", "MT_19", "MT_20", "MT_21", "MT_22", "MT_23", "MT_24", "MT_25", "MT_26", "MT_27", "MT_28", "MT_29", "MT_30", "MT_31", "MT_32"};
const char* yPins10[8]  = {"B_33", "B_34", "B_35", "B_36", "B_37", "B_38", "B_39", "B_40"};

// B_40 - B_48
const char* xPins11[16] = {"MT_1", "MT_2", "MT_3", "MT_4", "MT_5", "MT_6", "MT_7", "MT_8", "MT_9", "MT_10", "MT_11", "MT_12", "MT_13", "MT_14", "MT_15", "MT_16"};
const char* yPins11[8]  = {"B_41", "B_42", "B_43", "B_44", "B_45", "B_46", "B_47", "B_48"};

const char* xPins12[16] = {"MT_17", "MT_18", "MT_19", "MT_20", "MT_21", "MT_22", "MT_23", "MT_24", "MT_25", "MT_26", "MT_27", "MT_28", "MT_29", "MT_30", "MT_31", "MT_32"};
const char* yPins12[8]  = {"B_41", "B_42", "B_43", "B_44", "B_45", "B_46", "B_47", "B_48"};

// B_48 - B_56
const char* xPins13[16] = {"MT_1", "MT_2", "MT_3", "MT_4", "MT_5", "MT_6", "MT_7", "MT_8", "MT_9", "MT_10", "MT_11", "MT_12", "MT_13", "MT_14", "MT_15", "MT_16"};
const char* yPins13[8]  = {"B_49", "B_50", "B_51", "B_52", "B_53", "B_54", "B_55", "B_56"};

const char* xPins14[16] = {"MT_17", "MT_18", "MT_19", "MT_20", "MT_21", "MT_22", "MT_23", "MT_24", "MT_25", "MT_26", "MT_27", "MT_28", "MT_29", "MT_30", "MT_31", "MT_32"};
const char* yPins14[8]  = {"B_49", "B_50", "B_51", "B_52", "B_53", "B_54", "B_55", "B_56"};

// B_56 - B_60
const char* xPins15[16] = {"MT_1", "MT_2", "MT_3", "MT_4", "MT_5", "MT_6", "MT_7", "MT_8", "MT_9", "MT_10", "MT_11", "MT_12", "MT_13", "MT_14", "MT_15", "MT_16"};
const char* yPins15[8]  = {"B_57", "B_58", "B_59", "B_60", "GND", "GND", "GND", "GND"};

const char* xPins16[16] = {"MT_17", "MT_18", "MT_19", "MT_20", "MT_21", "MT_22", "MT_23", "MT_24", "MT_25", "MT_26", "MT_27", "MT_28", "MT_29", "MT_30", "MT_31", "MT_32"};
const char* yPins16[8]  = {"B_57", "B_58", "B_59", "B_60", "GND", "GND", "GND", "GND"};



// B_61 - B_68
const char* xPins17[16] = {"MT_1", "MT_2", "MT_3", "MT_4", "MT_5", "MT_6", "MT_7", "MT_8", "MT_9", "MT_10", "MT_11", "MT_12", "MT_13", "MT_14", "MT_15", "MT_16"};
const char* yPins17[8]  = {"B_61", "B_62", "B_63", "B_64", "B_65", "B_66", "B_67", "B_68"};

const char* xPins18[16] = {"MT_17", "MT_18", "MT_19", "MT_20", "MT_21", "MT_22", "MT_23", "MT_24", "MT_25", "MT_26", "MT_27", "MT_28", "MT_29", "MT_30", "MT_31", "MT_32"};
const char* yPins18[8]  = {"B_61", "B_62", "B_63", "B_64", "B_65", "B_66", "B_67", "B_68"};

// B_69 - B_76
const char* xPins19[16] = {"MT_1", "MT_2", "MT_3", "MT_4", "MT_5", "MT_6", "MT_7", "MT_8", "MT_9", "MT_10", "MT_11", "MT_12", "MT_13", "MT_14", "MT_15", "MT_16"};
const char* yPins19[8]  = {"B_69", "B_70", "B_71", "B_72", "B_73", "B_74", "B_75", "B_76"};

const char* xPins20[16] = {"MT_17", "MT_18", "MT_19", "MT_20", "MT_21", "MT_22", "MT_23", "MT_24", "MT_25", "MT_26", "MT_27", "MT_28", "MT_29", "MT_30", "MT_31", "MT_32"};
const char* yPins20[8]  = {"B_69", "B_70", "B_71", "B_72", "B_73", "B_74", "B_75", "B_76"};

// B_77 - B_84
const char* xPins21[16] = {"MT_1", "MT_2", "MT_3", "MT_4", "MT_5", "MT_6", "MT_7", "MT_8", "MT_9", "MT_10", "MT_11", "MT_12", "MT_13", "MT_14", "MT_15", "MT_16"};
const char* yPins21[8]  = {"B_77", "B_78", "B_79", "B_80", "B_81", "B_82", "B_83", "B_84"};

const char* xPins22[16] = {"MT_17", "MT_18", "MT_19", "MT_20", "MT_21", "MT_22", "MT_23", "MT_24", "MT_25", "MT_26", "MT_27", "MT_28", "MT_29", "MT_30", "MT_31", "MT_32"};
const char* yPins22[8]  = {"B_77", "B_78", "B_79", "B_80", "B_81", "B_82", "B_83", "B_84"};

// B_85 - B_92
const char* xPins23[16] = {"MT_1", "MT_2", "MT_3", "MT_4", "MT_5", "MT_6", "MT_7", "MT_8", "MT_9", "MT_10", "MT_11", "MT_12", "MT_13", "MT_14", "MT_15", "MT_16"};
const char* yPins23[8]  = {"B_85", "B_86", "B_87", "B_88", "B_89", "B_90", "B_91", "B_92"};

const char* xPins24[16] = {"MT_17", "MT_18", "MT_19", "MT_20", "MT_21", "MT_22", "MT_23", "MT_24", "MT_25", "MT_26", "MT_27", "MT_28", "MT_29", "MT_30", "MT_31", "MT_32"};
const char* yPins24[8]  = {"B_85", "B_86", "B_87", "B_88", "B_89", "B_90", "B_91", "B_92"};

// B_93 - B_100
const char* xPins25[16] = {"MT_1", "MT_2", "MT_3", "MT_4", "MT_5", "MT_6", "MT_7", "MT_8", "MT_9", "MT_10", "MT_11", "MT_12", "MT_13", "MT_14", "MT_15", "MT_16"};
const char* yPins25[8]  = {"B_93", "B_94", "B_95", "B_96", "B_97", "B_98", "B_99", "B_100"};

const char* xPins26[16] = {"MT_17", "MT_18", "MT_19", "MT_20", "MT_21", "MT_22", "MT_23", "MT_24", "MT_25", "MT_26", "MT_27", "MT_28", "MT_29", "MT_30", "MT_31", "MT_32"};
const char* yPins26[8]  = {"B_93", "B_94", "B_95", "B_96", "B_97", "B_98", "B_99", "B_100"};

// B_101 - B_108
const char* xPins27[16] = {"MT_1", "MT_2", "MT_3", "MT_4", "MT_5", "MT_6", "MT_7", "MT_8", "MT_9", "MT_10", "MT_11", "MT_12", "MT_13", "MT_14", "MT_15", "MT_16"};
const char* yPins27[8]  = {"B_101", "B_102", "B_103", "B_104", "B_105", "B_106", "B_107", "B_108"};

const char* xPins28[16] = {"MT_17", "MT_18", "MT_19", "MT_20", "MT_21", "MT_22", "MT_23", "MT_24", "MT_25", "MT_26", "MT_27", "MT_28", "MT_29", "MT_30", "MT_31", "MT_32"};
const char* yPins28[8]  = {"B_101", "B_102", "B_103", "B_104", "B_105", "B_106", "B_107", "B_108"};

// B_109 - B_116
const char* xPins29[16] = {"MT_1", "MT_2", "MT_3", "MT_4", "MT_5", "MT_6", "MT_7", "MT_8", "MT_9", "MT_10", "MT_11", "MT_12", "MT_13", "MT_14", "MT_15", "MT_16"};
const char* yPins29[8]  = {"B_109", "B_110", "B_111", "B_112", "B_113", "B_114", "B_115", "B_116"};

const char* xPins30[16] = {"MT_17", "MT_18", "MT_19", "MT_20", "MT_21", "MT_22", "MT_23", "MT_24", "MT_25", "MT_26", "MT_27", "MT_28", "MT_29", "MT_30", "MT_31", "MT_32"};
const char* yPins30[8]  = {"B_109", "B_110", "B_111", "B_112", "B_113", "B_114", "B_115", "B_116"};

// B_117 - B_120
const char* xPins31[16] = {"MT_1", "MT_2", "MT_3", "MT_4", "MT_5", "MT_6", "MT_7", "MT_8", "MT_9", "MT_10", "MT_11", "MT_12", "MT_13", "MT_14", "MT_15", "MT_16"};
const char* yPins31[8]  = {"B_117", "B_118", "B_119", "B_120", "+5V", "5V", "+3V3", "+3V3"};

const char* xPins32[16] = {"MT_17", "MT_18", "MT_19", "MT_20", "MT_21", "MT_22", "MT_23", "MT_24", "MT_25", "MT_26", "MT_27", "MT_28", "MT_29", "MT_30", "MT_31", "MT_32"};
const char* yPins32[8]  = {"B_117", "B_118", "B_119", "B_120", "+5V", "5V", "+3V3", "+3V3"};

// Analyzer
const char* xPins33[16] = {"MT_1", "MT_2", "MT_3", "MT_4", "MT_5", "MT_6", "MT_7", "MT_8", "MT_9", "MT_10", "MT_11", "MT_12", "MT_13", "MT_14", "MT_15", "MT_16"};
const char* yPins33[8]  = {"PA_0", "PA_1", "PA_2", "PA_3", "PA_4", "PA_5", "PA_6", "PA_7"};

const char* xPins34[16] = {"MT_17", "MT_18", "MT_19", "MT_20", "MT_21", "MT_22", "MT_23", "MT_24", "MT_25", "MT_26", "MT_27", "MT_28", "MT_29", "MT_30", "MT_31", "MT_32"};
const char* yPins34[8]  = {"PA_0", "PA_1", "PA_2", "PA_3", "PA_4", "PA_5", "PA_6", "PA_7"};


#endif // MUXCONFIG_H
