Ne-Se-Chete/CableUndefined-Embedded/(commit log)

2023-11-02 Pico works on linux
2024-01-20 ESP32 AND RASPBERRY PI PICO WORKS!!!
2024-02-25 fix bug with main_breadboard and mcu_breadboard indexes
    [main.cpp]
2024-02-26 add BFS search and print Device from index
2024-02-28 Add PCB's
    [PCB_CableUndefined1stPrototype_2024-02-18.kicad_pcb, PCB_CableUndefinedMini_Rev2.json]
2024-03-01 add printing functions for founded paths
2024-03-03 add printing founded paths to txt file
2024-03-28 add code for printing SetConections
2024-03-29 remove checkBidirectional and printConnections. Removed dynamic_cast and virtual. Working pathfiding
2024-03-30 removed printing to file and to_string
2024-04-16 demonza para
2024-05-01 python demo connections work, to ad UI
    [SCH_CableUndefinedMini Rev2_2024-05-01.json]
2024-05-10 add some pcb files
2024-05-11 FRONTENT add: when a button is clicked a new window is opened with the data init
2024-09-17 setting up mux pins (adding schematic in code basically)
2024-09-18 main track control
2024-09-18 fix ay and ax calculation in setconnection
    [main.cpp]
2025-02-19 add base test code for STM32HAL MUX testing with C
    [Cable Undefined V3 Debug.cfg]
2025-02-19 name fix
    [Cable Undefined V3 Debug.cfg]
2025-02-19 name fix 2
    [Cable Undefined V3 Debug.cfg]
2025-02-22 add partial algorithm for pathfinding
    [Cable Undefined V3 Debug.cfg]
2025-02-27 Full working pathfinding +UART receive from PC (CP2102)
2025-03-03 UART works with ESP and CP2102, with interrupts
2025-03-08 ADC sig analyzer works
2025-03-09 fault works!, to look at tim6 and leds (tim1)
2025-03-15 feat: adding pwm tim2 ch1 pa15
2025-03-18 WORKING LEDS TF DMA IS SHIT
2025-03-18 add removing leds and CLR for leds is tested
2025-03-18 fix so Route 1-5, 5-10, Remove 5-10, removes only LED 10 + CLR FIXES
    [leds.c, main.c, mux.c]
2025-03-25 restructure repo + fixed strange 2 route connection bug accidental removal + fixed needles increment of maintrack and muxusage vars on repetative commands
    [Cable Undefined V3 Debug.cfg, PCB_CableUndefined1stPrototype_2024-02-18.kicad_pcb, PCB_CableUndefinedMini_Rev2.json, SCH_CableUndefinedMini Rev2_2024-05-01.json]
2025-03-25 add PCB's and schematics
2025-03-25 fix leds not turrning off on redundant same connections
    [mux.c]
2025-03-25 add DMA for ADC, made UART faster 1700us per sample, because of printf. Have to fix
    [Cable Undefined V3.ioc, main.c, signal_analyzer.c, signal_analyzer.h]
2025-03-25 Signal analyzer ~80us on 1 signal = ~12khz, added ADC turning on optimisation, sending only on 1 uart, ad python test file
2025-04-08 add NOT WORKIGN LOGIC FOR DIGITAL SIG ANALYZER
    [SignalAnalyzerSerial.py, main.c, mux.c, signal_analyzer.c, signal_analyzer.h]
2025-04-08 add sampling time and digital to Adc and bak works, digital doesnt measure properly
    [Cable Undefined V3 Debug.cfg]
2025-04-24 final commit, closing Cable Undefined V3 project, greetings
    [Cable Undefined V3 Debug.cfg]
